revk/ESP32-PN532/PCB/Round/README.md

# Round

These files are for use in [KiCad](https://www.kicad.org).

## Trademark

This is an open source project, but bear in mind you cannot sell boards bearing the Andrews & Arnold Ltd name, the A&A logo, the registered trademark AJK logo, or the GS1 allocated EANs assigned to Andrews & Arnold Ltd.

## Images

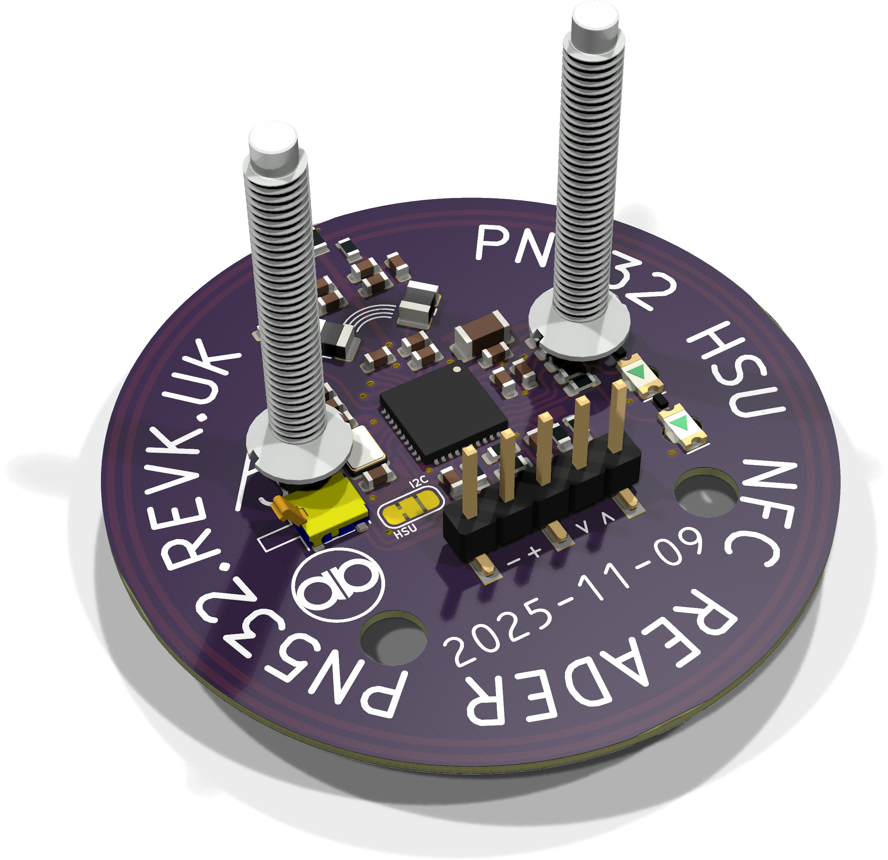
[picture p2: PCB/Round/Round.png]
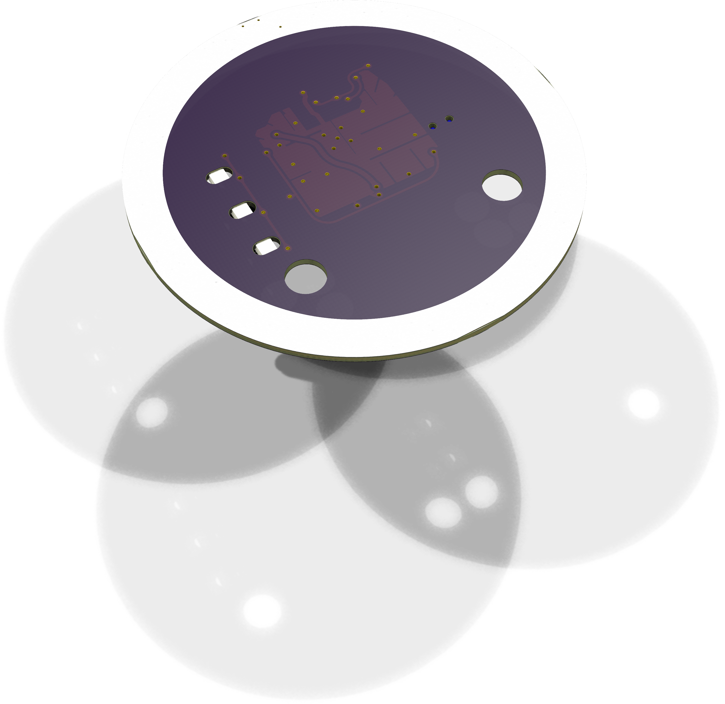
[picture p3: PCB/Round/Round-bottom.png]

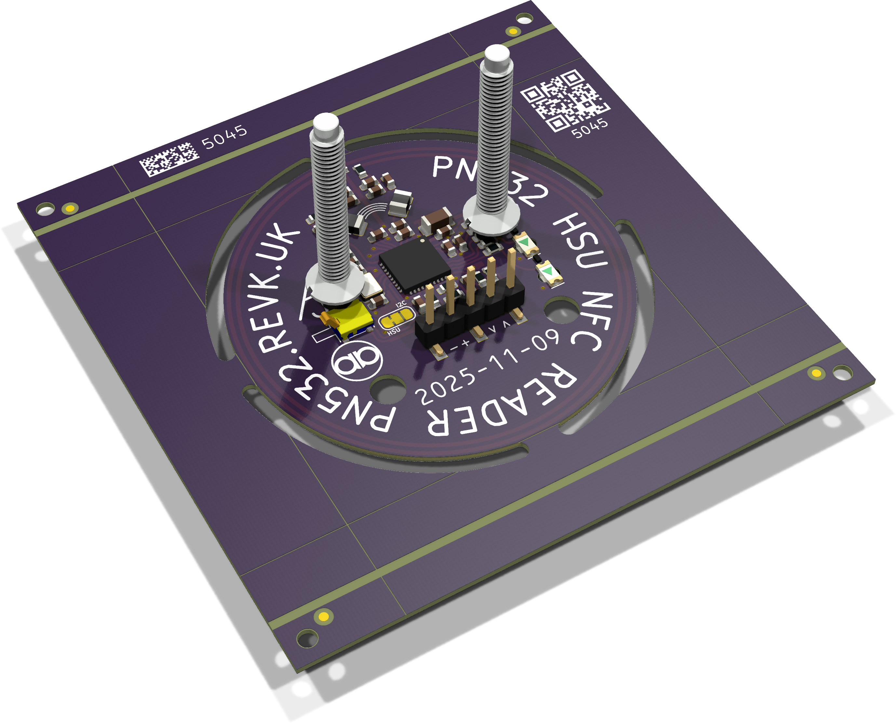
[picture p4: PCB/Round/Round-panel.png]
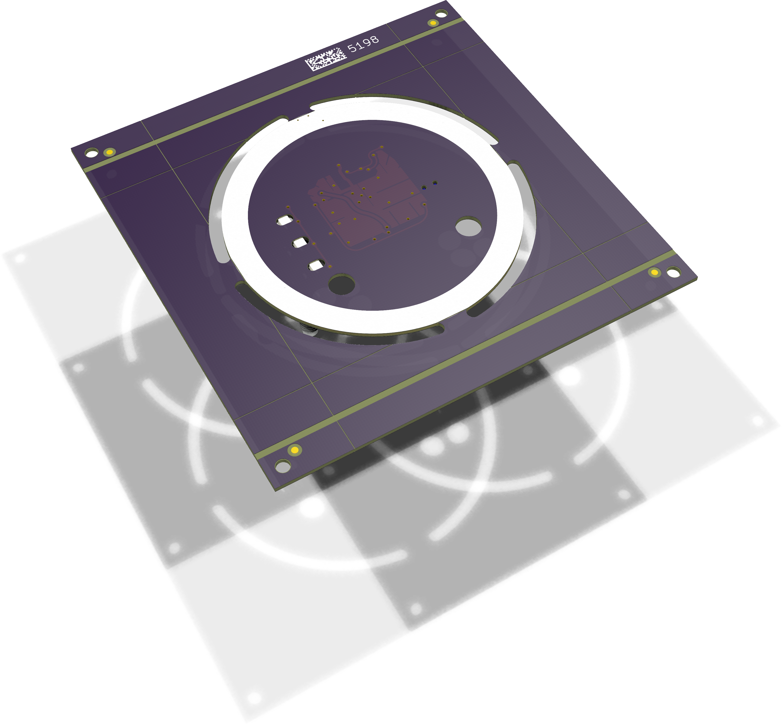
[picture p5: PCB/Round/Round-panel-bottom.png]


*Auto generated 2025-08-22T10:13:34*
