revk/ESP32-PN532/PCB/Square/README.md

# Square

These files are for use in [KiCad](https://www.kicad.org).

## Trademark

This is an open source project, but bear in mind you cannot sell boards bearing the Andrews & Arnold Ltd name, the A&A logo, the registered trademark AJK logo, or the GS1 allocated EANs assigned to Andrews & Arnold Ltd.

## Images

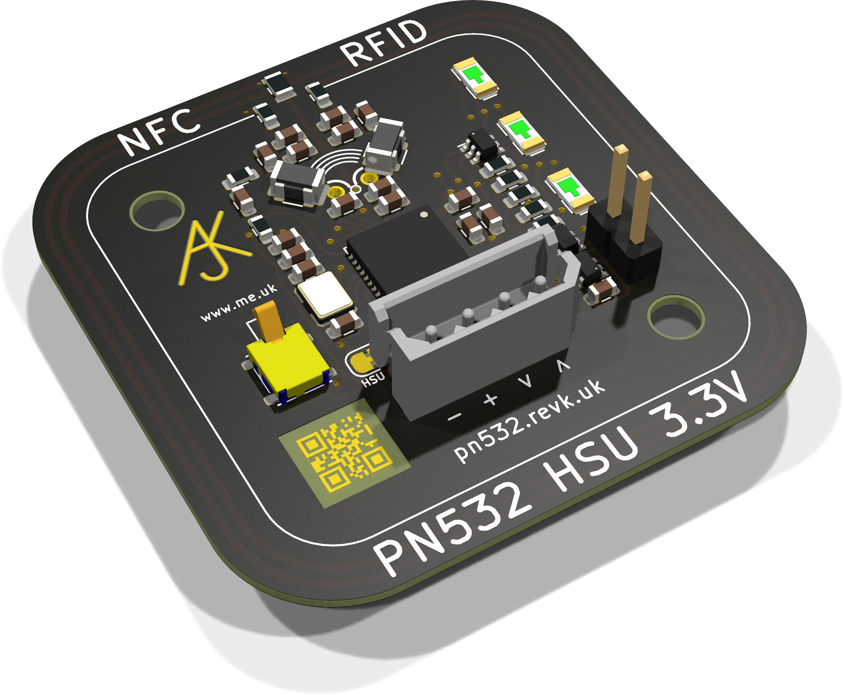
[picture p6: PCB/Square/Square.png]
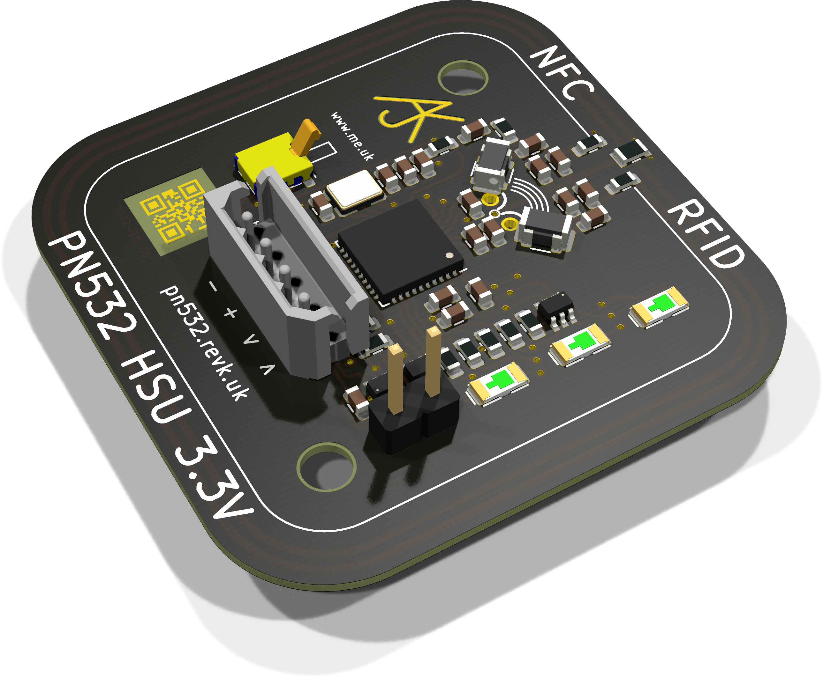
[picture p7: PCB/Square/Square-90.png]
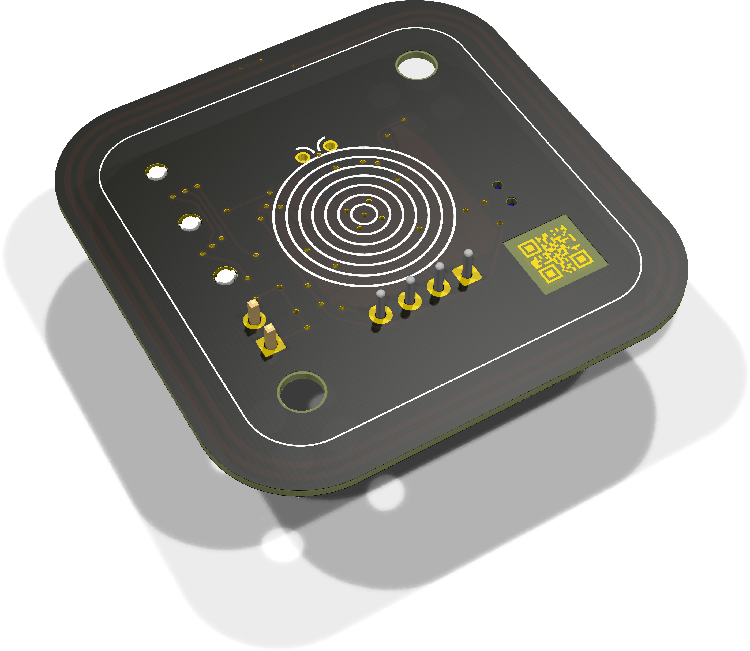
[picture p8: PCB/Square/Square-bottom.png]


*Auto generated 2025-08-17T07:40:48*
