revk/ESP32-PN532/PCB/blankplate.png

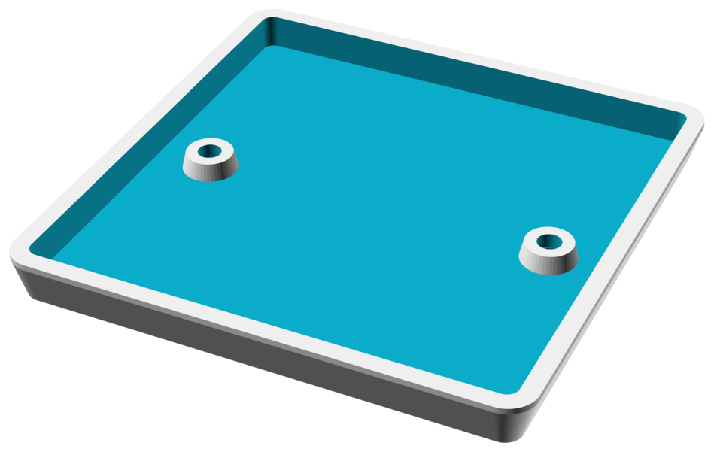
PCB/blankplate.png
