revk/ESP32-PN532/PCB/Round-Base.png

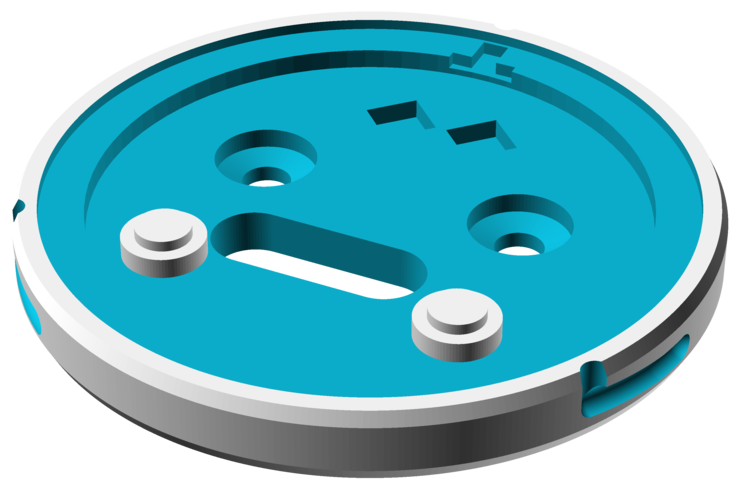
PCB/Round-Base.png
