revk/ESP32-PN532/PCB/Round-Plate90.png

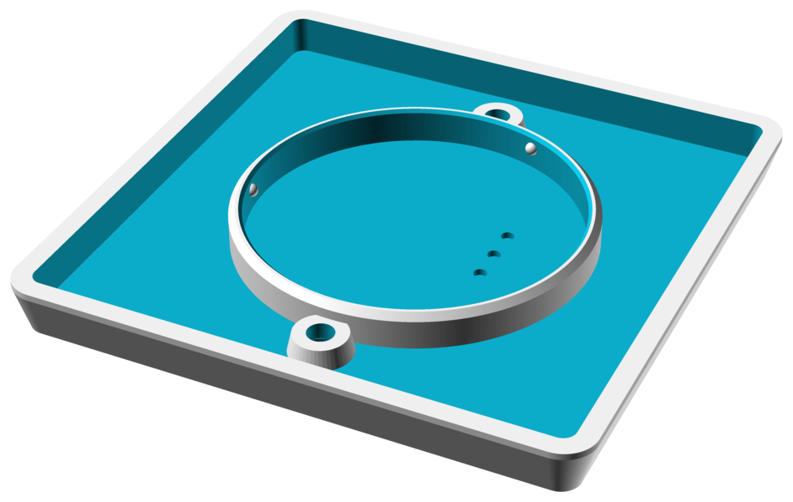
PCB/Round-Plate90.png
