revk/ESP32-PN532/PCB/Round-Top.png

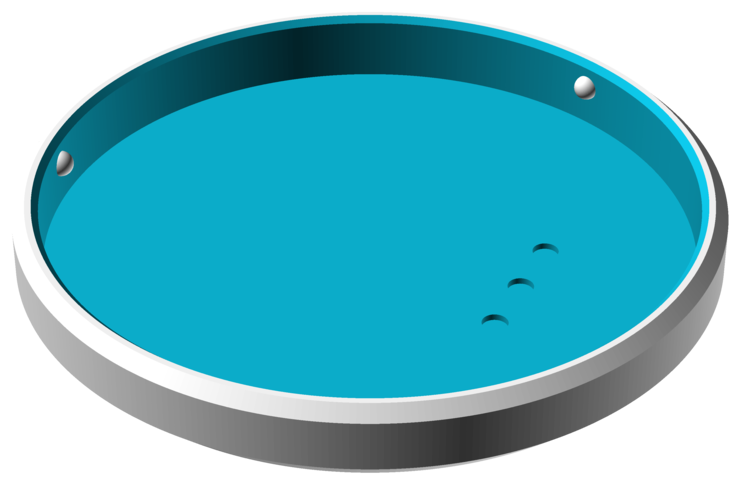
PCB/Round-Top.png
