revk/ESP32-PN532/PCB/Square/Cable.stl

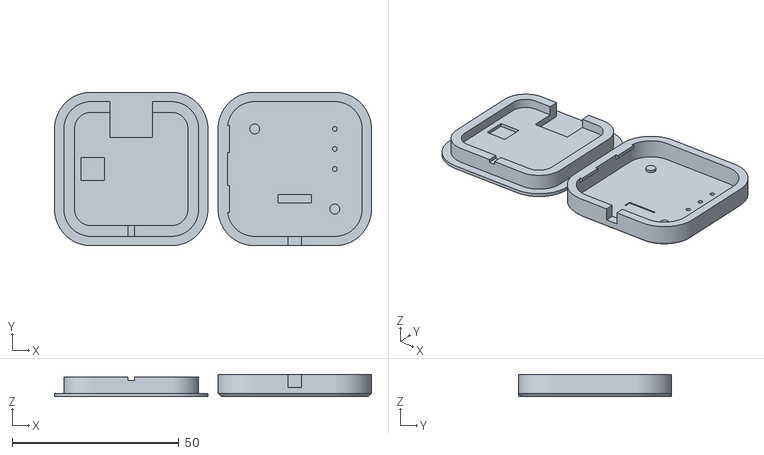
[picture p13: CAD file, 2023-07-02]
PCB/Square/Cable.stl
95.0 x 46.0 x 6.70
