revk/ESP32-PN532/PCB/Square/Wall.stl

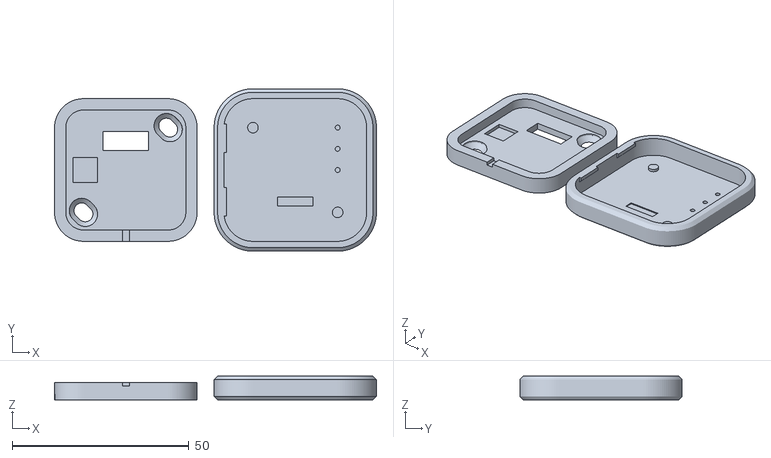
[picture p14: CAD file, 2023-07-02]
PCB/Square/Wall.stl
91.2 x 46.0 x 6.70
