revk/ESP32-PN532/PCB/Square/Thick.stl

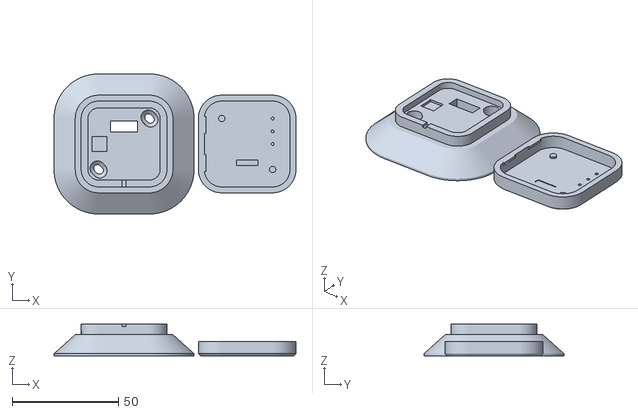
[picture p15: CAD file, 2023-07-02]
PCB/Square/Thick.stl
114.0 x 66.0 x 14.9
