revk/ESP32-PN532/PCB/Round-Plate.scad

include <Round.scad>
use <blankplate.scad>
use <Round-top.scad>

difference()
{
    blankplate();
    cylinder(r=pcbr+wall,h=base);
}
top(top=2); // to match blankplate
