revk/ESP32-PN532/PCB/Round.scad

// Design for round base to print in resin

pcbr=46/2;
pcbt=0.8;
parts=1.5;
base=5.5;
top=1.5;
wall=2;
nipple=2;
diag=0.5;
lt=2;
lb=1;
lw=2;

$fn=90;

conno=0.7; // Offset
connh=6;
connw=16;

locka=20;

ledr=1;
ledt=1;
