revk/ESP32-PN532/(list of files, cad)

Other CAD files:
PCB/Round-Plate90.scad
