revk/ESP32-PN532/(threads)

Thread 1 (2021-02-08):

Please make an example

GeorgeFlorian, 2021-02-08:
Hello.

I don't know if this is still maintained or not, but I would really love an example on how to use this library.

I am currently trying to integrate RFID1356MIFARE with ESP32-EVB but with no luck.

Thank you.

revk, 2021-02-08:
It is used in https://github.com/revk/SolarSystem which should give a good example.

GeorgeFlorian, 2021-02-09:
> It is used in https://github.com/revk/SolarSystem which should give a good example.

I trust that it is, but I find it hard to follow. Can you point me to the right files ? Thank you.

revk, 2021-03-23:
pn532_init is where you tell it the uart and pins. It is probably worth reading the include file to start with.

revk, 2021-04-23:
I think that answers the question.

Closed 2021-04-23.

Thread 2 (2021-12-05):

Assembled boards

rabarar, 2021-12-05:
Revk do you sell an assembled board? I want to do some experiments to start and cook want to green up board fan for unit one.

revk, 2021-12-05:
I am thinking of doing so - chip supply is an issue, and we have been working out if they can be sold as "parts" without CE/UKCA marking, which we think they may be. But no idea when.

rabarar, 2021-12-05:
Thanks! I’ll watch the repo for an update if/when you decide you can — thanks again!

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

Closed 2021-12-05.

Thread 3 (2021-12-29):

The project symbol library cache file 'PN532-cache.lib' was not found.

hillstub, 2021-12-29:
Hi revk,
Thanks for your awesome work!!

I'm working on making an ESP32-based board (ESP32-H2 once it's available) with NFC. Currently, I'm trying to get some inspiration from your project ;-).

Unfortunately, when I open the KiCad schematic file, I'm getting the following error: "The project symbol library cache file 'PN532-cache.lib' was not found." Am I doing something wrong or is it looking for a file that's not in the repo?

Thanks again!

revk, 2021-12-29:
OK not sure, I am just updating stuff to kicad 6 now though.

revk, 2021-12-29:
I have updated the files for KiCad 6 - hope that helps.

hillstub, 2021-12-29:
Yes! That resolved the issue - tnx!!

Closed 2021-12-29.

Thread 4 (2022-09-23):

Code sample using library fucntions

freitasartur, 2022-09-23:
Hi, would you mind providing a code sample using the library functions?

I'm begineer in nfc and I'm not sure on how to use it.

Thank you very much in advance.

Artur

revk, 2022-09-23:
See https://github.com/revk/SolarSystem/blob/master/ESP32/main/nfc.c

Closed 2022-09-23.

Thread 5 (2023-01-21):

Interesting project.

RaveGun, 2023-01-21:
Nice project.

I did some, too much, time ago for the office where I work, a NFC reader to count the number of coffees each one is drinking. We all have some NFC access IDs with unique ID number. The device is made out of the Wemos D1 Mini, a SD card adapter, an OLED display, a PN532 dev-board (the bigger blue one) and a custom board to glue everything together. It is all in my GitHub.

Now that our team has expanded was needed to build another one and it was so hard to find similar parts that are working like the old one. The software is also old and I just found the binary from back then and programmed the new board. After a lot of stress and debugging I managed to make a new device. This made me thinking I should try to build a new version with newer components.

**Do you think that the PN532 is still the way to go for a NFC reader?**
I need to mention that the IDs are of some Desfire type so I guess are more special then the regular NFC coins and need some features. The usual MFRC522 is not good enough.

I think that the ESP + NFC chip + SD card shall be integrated on one board.
The device I am thinking of does not have to be too small, it shall accommodate for an off the shelf >2.5" display.

**Can the NFC antenna be bigger than a credit card?**
For me antennas are some sort of voodoo magic.

revk, 2023-01-21:
The PN532 works with DESFire, that is what we are using it for.

I have generally kept the NFC on a separate board. I suspect it could be done on one board with care.

Antennas are voodoo, and this one works. Why do you need bigger than a credit card. It works well with the credit card size devices, from several cm away in fact.

RaveGun, 2023-01-21:
It looks like the PN532 is EOL and there are other recommended ICs now, this is why I was asking.

I was thinking that, if it is bigger I will be easier to integrate all in one PCB and save on the board to board connections.
Also, to do it on one side and then just order the PCBs with assembly. I don't know, I am just thinking(writing) out loud :)
I am an embedded SW guy and know about HW and HW design just enough to be able to find where the micro-controller's pins are going :)

Thank you for your time.

revk, 2023-01-21:
Yeh, I have not yet looked at alternative chips. Need to work out how much the interface changes as well. And designing an RF board is always, err, fun... So I may well make a new design soon. But PN532 work well for now.

revk, 2023-01-21:
Also, the PN7150 does not have HSU or GPIO. For my applications the reader is on a short lead which is far better done as HSU where the pins are driven all the time, than I2C, and I use the GPIO for LEDs. Would be interesting to find a newer chip that does HSU and GPIO like the PN532. Suggestions welcome.

RaveGun, 2023-01-22:
It looks like the PN5331B3HN is the next one in the list, that is still active and matches your requirements. It has no SPI nor I2C but it has USB2.0 as an interface. This is interesting as there are now also boards in internet that have the PN532 and an USB interface (something with GRID v2).

Closed 2023-01-21.

Thread 6 (2023-04-30):

Hello,Master..

CY202032, 2023-04-30:
This PCB does not have SPI mode. I have checked that it only has HSU and I2C modes. I hope you can add SPI mode. Then I will be very happy, Thank for you!

revk, 2023-04-30:
Correct, HSU seems fast enough as the response times mainly related to the NFC side. These is a link that can change to I2C mode though. This has not been tested.

Closed 2023-04-30.

Thread 7 (2025-04-09):

I2c mode doesn't appear to work

3rdIteration, 2025-04-09:
I'm looking at adapting this for a raspberry pi hat and got a few of the square boards fabricated as a test.

The UART functionality works, but not i2c, and when looking at the documentation and some other designs, I think the communication mode pins are backwards.

I'm happy to make a tweak, have it fabbed, test and bring a PR if that helps.

revk, 2025-04-09:
I have only ever tested UART as it seems fast enough (most time is not in the comms).

But if just wrong way around it just needs labels changed I assume.

Thread 8 (2025-05-10):

nice...

smoochiee, 2025-05-10:
any chance on how you design antenna and inputs?

revk, 2025-05-10:
It's all voodoo.

To start, I made exact same length as someone else's design.

I then did some trial and error on the tuning caps on the final board.

smoochiee, 2025-05-10:
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

does i2c works on this?..you have discord?

revk, 2025-05-10:
I have not tested I2C, but there is a link to change the lines to be I2C, so it should - check datasheet to be sure.

I found serial to be better as lines properly driven both ways (unlike I2C with pull ups), and the time for serial data transfer is not the limiting factor. So especially if on longer wires the serial approach is way better.

discord? no?

smoochiee, 2025-05-10:
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

what caps usually you change... i want to design a rfid antenna to fit my boardhttps://github.com/user-attachments/assets/f25bb927-b065-4898-b3a3-12e6f198d1a5

revk, 2025-05-10:
The 22pF ones

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

smoochiee, 2025-05-10:
> The 22pF ones
>
> 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

thanks...you use this?
https://eds.st.com/antenna/#/

smoochiee, 2025-05-10:
> The 22pF ones
>
> 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

and this r56 inductor is fix for this pn532?its in datasheet?thanks..
