revk/ESP32-PN532/PCB/Round/Round.kicad_pcb

## KiCad design PCB/Round/Round.kicad_pcb (2025-11-09)

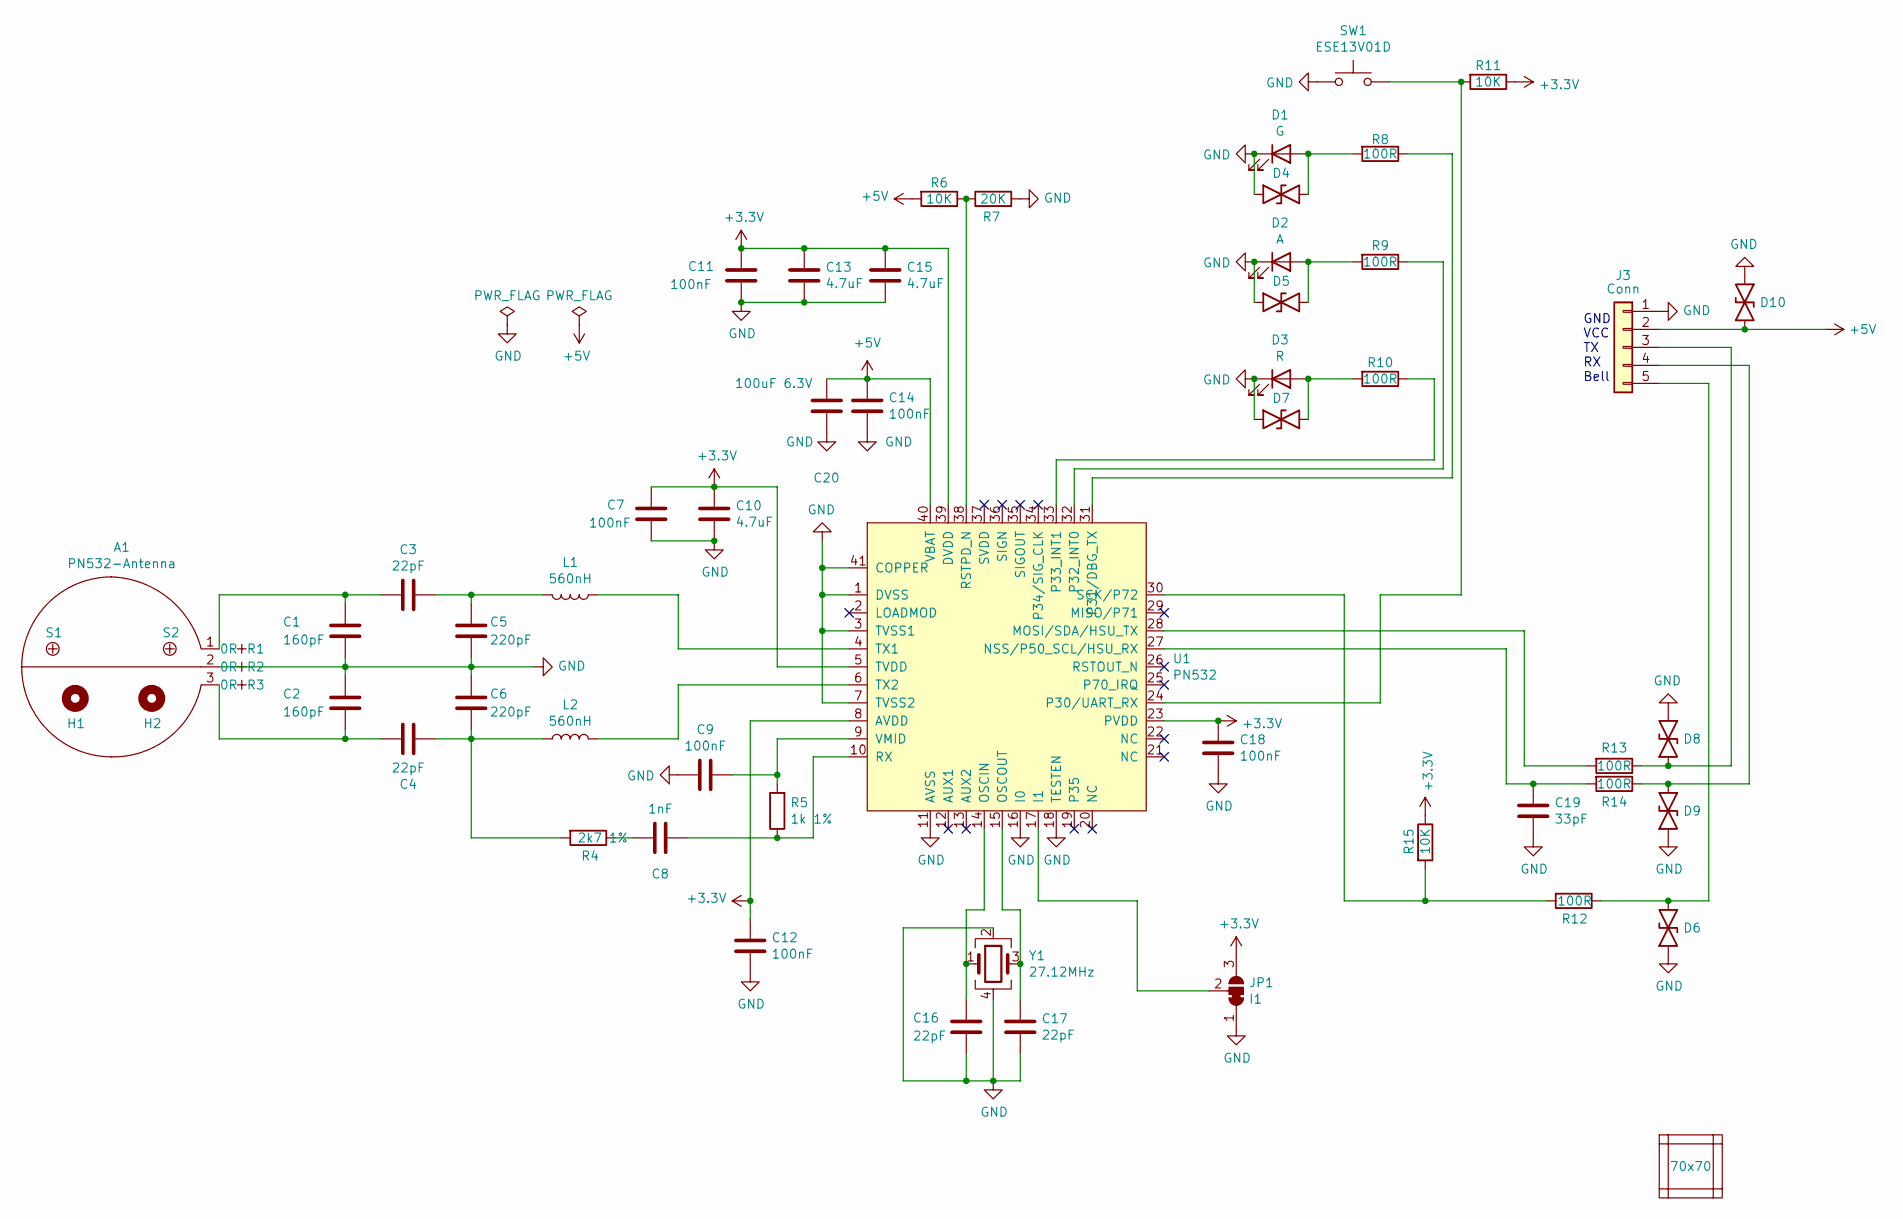
[picture p16: schematic Round.kicad_sch, PN532 NFC Board]

Parts:
A1: PN532-Antenna; PN532-Antenna6
C1, C2: 160pF; C_0603
C3, C4: 22pF; C_0603; Part No 0603N220F500CT
C5, C6: 220pF; C_0603; Part No 0603-220pF-50V
C7, C9, C11, C12, C14, C18: 100nF; C_0603; Part No 0603-100nF-25V
C8: 1nF; C_0603; Part No VJ0603A102GXAPW1BC
C10, C13, C15: 4.7uF; C_0603; Part No 0603-4.7uF-10V
C16, C17: 22pF; C_0603; Part No 0603-22pF-50V
C19: 33pF; C_0603; Part No 0603-33pF-50V
C20: 100uF 6.3V; C_1206
D1: G; LED_1206_Rev_Square; Part No 156120VS75300
D2: A; LED_1206_Rev_Square; Part No 156120YS75300
D3: R; LED_1206_Rev_Square; Part No 156120RS75300
D4, D5, D6, D7, D8, D9, D10: DFN1006-2L; MPN C5137770
H1, H2: MountingHole; MountingHole_4mm
J3: Conn; PinHeader_1x05_P2.54mm_Vertical_SMD_Pin1Left; MPN C2883802
JP1: I1; SolderJumper3
L1, L2: 560nH; L_1008_2520Metric; Part No LQW2UASR56G00L
PCB1: 70x70; PCB7070
R1, R3: 0R; R_0603_; MPN 0603
R2: 0R; R_0805_; MPN C17477
R4: 2k7 1%; R_0603; MPN C114612
R5: 1k 1%; R_0603; Part No CRCW06031K00FKEAC
R6, R11, R15: 10K; R_0603; MPN C25804
R7: 20K; R_0603; MPN C4184
R8, R9, R10, R13, R14: 100R; R_0603; MPN C22775
R12: 100R; R_0603; MPN 0603-100R
S1, S2: Screw
SW1: ESE13V01D; ESE13; Part No ESE13V01D
U1: PN532; QFN-40-1EP_6x6mm_P0.5mm_EP4.6x4.6mm; MPN C28925
V1, V2, V3, V4: VCUT70
Y1: 27.12MHz; Crystal-3.2x2.5; Part No ABM81-27.120MHZ-10-B1U-T3

Connections:
+3.3V: C7.1, C10.1, C11.1, C12.1, C13.1, C15.1, C18.1, JP1.3 (B), R11.1, R15.1, U1.5 (TVDD), U1.8 (AVDD), U1.23 (PVDD), U1.39 (DVDD)
+5V: C14.1, C20.2, D10.2, J3.2, R6.2, U1.40 (VBAT)
GND: A1.2, C1.2, C2.1, C5.1, C6.1, C7.2, C9.2, C10.2, C11.2, C12.2, C13.2, C14.2, C15.2, C16.2, C17.2, C18.2, C19.2, C20.1, D1.1 (K), D2.1 (K), D3.1 (K), D4.2, D5.2, D6.2, D7.2, D8.1, D9.2, D10.1, J3.1, JP1.1 (A), R7.2, SW1.1, U1.1 (DVSS), U1.3 (TVSS1), U1.7 (TVSS2), U1.11 (AVSS), U1.16 (I0), U1.18 (TESTEN), U1.41 (COPPER), Y1.2, Y1.4
unnamed: A1.1, C1.1, C3.2
unnamed: A1.3, C2.2, C4.1
unnamed: C3.1, C5.2, L1.2
unnamed: C4.2, C6.2, L2.1, R4.2
unnamed: C8.2, R4.1
unnamed: D1.2 (A), D4.1, R8.2
unnamed: D2.2 (A), D5.1, R9.2
unnamed: D3.2 (A), D7.1, R10.2
unnamed: D8.2, J3.3, R13.1
unnamed: D9.1, J3.4, R14.1
unnamed: D6.1, J3.5, R12.1
unnamed: JP1.2 (C), U1.17 (I1)
unnamed: R13.2, U1.28 (MOSI/SDA/HSU_TX)
unnamed: C19.1, R14.2, U1.27 (NSS/P50_SCL/HSU_RX)
unnamed: C16.1, U1.14 (OSCIN), Y1.1
unnamed: C17.1, U1.15 (OSCOUT), Y1.3
unnamed: R11.2, SW1.2, U1.24 (P30/UART_RX)
unnamed: R8.1, U1.31 (P31/DBG_TX)
unnamed: R9.1, U1.32 (P32_INT0)
unnamed: R10.1, U1.33 (P33_INT1)
unnamed: R6.1, R7.1, U1.38 (RSTPD_N)
unnamed: C8.1, R5.1, U1.10 (RX)
unnamed: R12.2, R15.2, U1.30 (SCK/P72)
unnamed: L1.1, U1.4 (TX1)
unnamed: L2.2, U1.6 (TX2)
unnamed: C9.1, R5.2, U1.9 (VMID)

Notes on the sheet:
GND VCC TX RX Bell

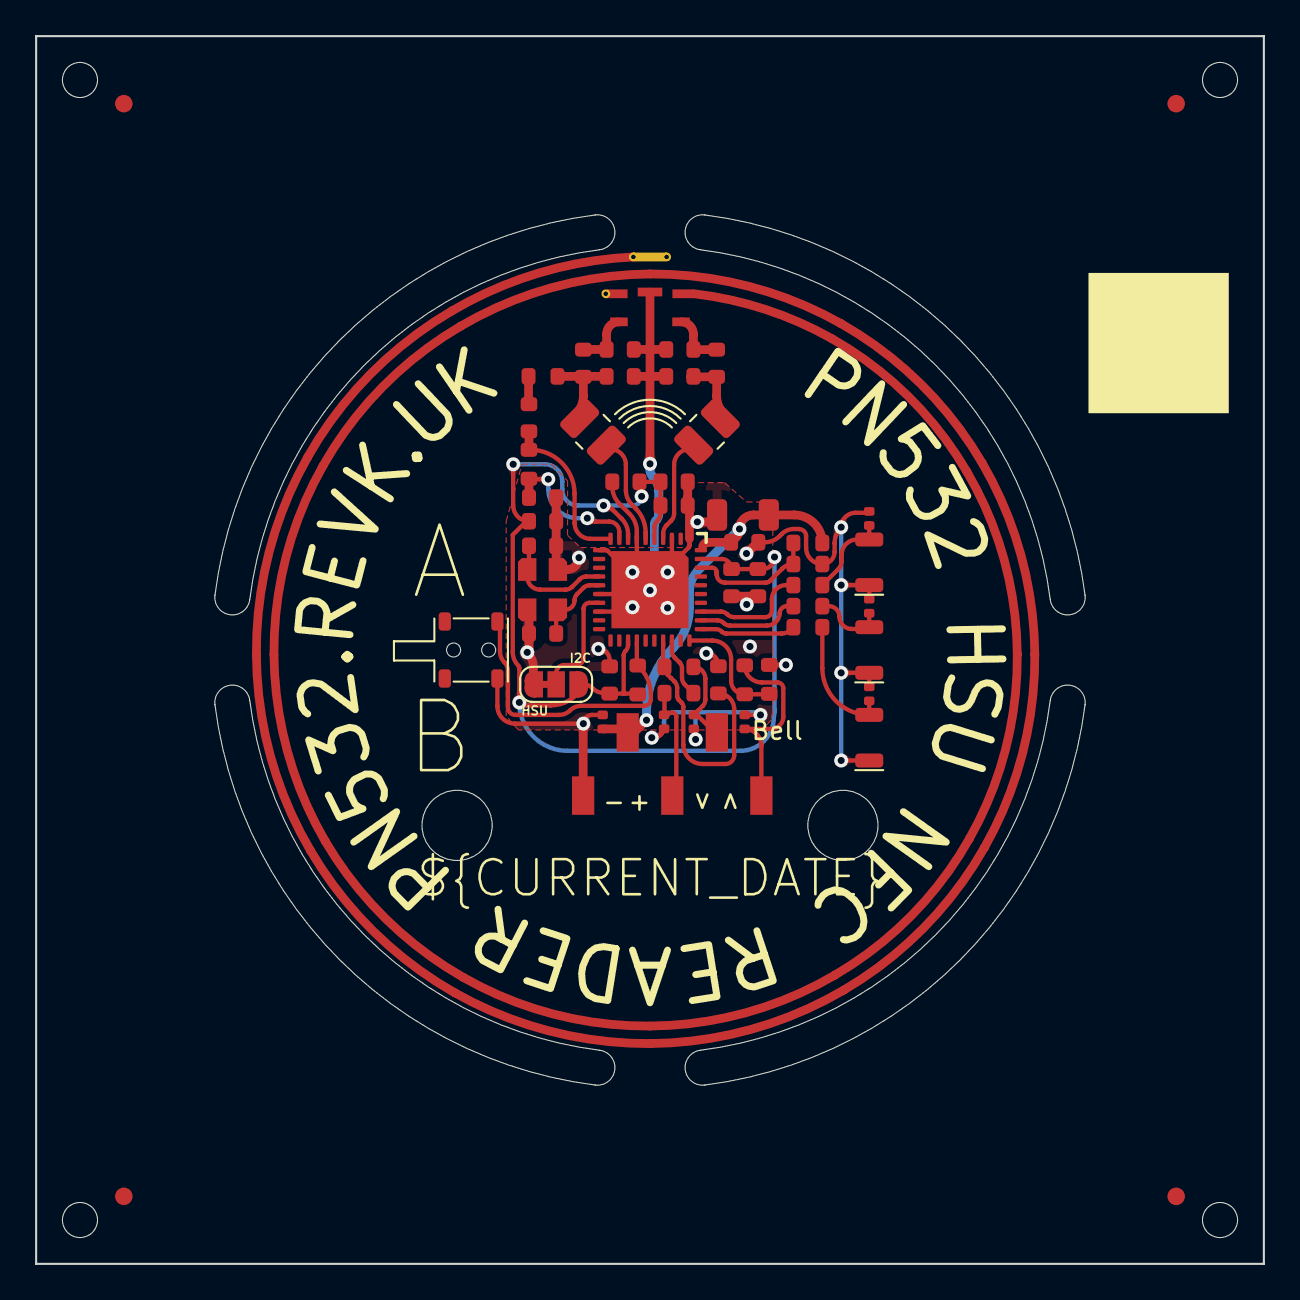
[picture p17: board Round.kicad_pcb from above]

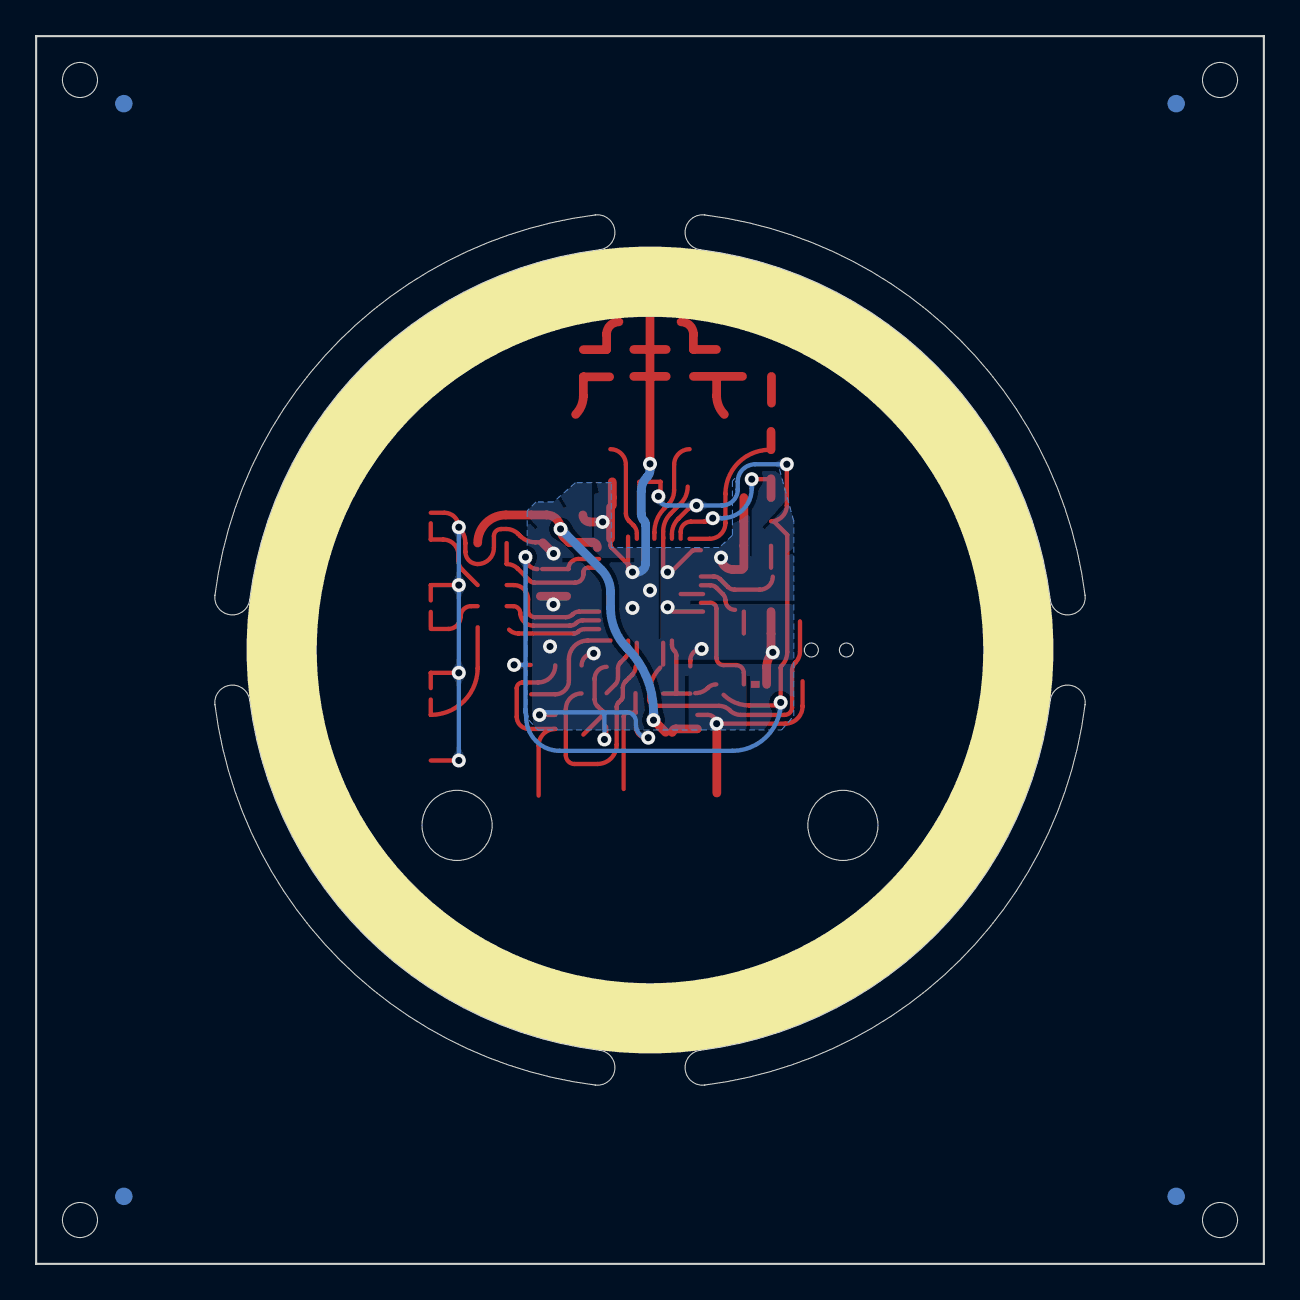
[picture p18: board Round.kicad_pcb from below]

Board: 2 copper layers, 70.0 x 70.0 mm, 62 parts (4 on the bottom side), 29 nets.
