revk/ESP32-PN532/makeloop.c

/* General spiral track - for PN532 antenna */
/* (c) 2021 Adrian Kennard Andrews & Arnold Ltd */

#define _GNU_SOURCE
#include <stdio.h>
#include <string.h>
#include <time.h>
#include <popt.h>
#include <err.h>
#include <float.h>
#include <fcntl.h>
#include <sys/stat.h>
#include <sys/mman.h>
#include <stdlib.h>
#include <ctype.h>
#include <unistd.h>
#include <math.h>

int
main (int argc, const char *argv[])
{
   const char *name = "PN532-Antenna6";
   const char *text = NULL;
   double startr = 22.69;
   double width = 0.5;
   double step = 1.0;
   double starta = NAN;
   double enda = NAN;
   double stepa = 30;
   double edge = NAN;
   double ring = NAN;
   double texth = 3;
   double textr = 18.5;
   double textt = 0.4;
   double screwx = NAN;
   double screwy = 0;
   double screwz = 1.25;
   double zone = 8;             // Fill exclude zone starts away from antenna
   double zap = 5;              // Fill exclusion zone has slots this deep
   double spoke = 12;           // Exclude spoke angle
   double slot = 1;             // Exclude slot angle
   int outside = 0;
   int debug = 0;
   poptContext optCon;          /* context for parsing  command - line options */
   {
      const struct poptOption optionsTable[] = {
         {"name", 0, POPT_ARG_STRING | POPT_ARGFLAG_SHOW_DEFAULT, &name, 0, "Name"},
         {"text", 0, POPT_ARG_STRING | POPT_ARGFLAG_SHOW_DEFAULT, &text, 0, "Text"},
         {"texth", 0, POPT_ARG_STRING | POPT_ARGFLAG_SHOW_DEFAULT, &texth, 0, "Text height"},
         {"startr", 0, POPT_ARG_DOUBLE | POPT_ARGFLAG_SHOW_DEFAULT, &startr, 0, "Start (outer) radius"},
         {"textr", 0, POPT_ARG_STRING | POPT_ARGFLAG_SHOW_DEFAULT, &textr, 0, "Text radius"},
         {"textt", 0, POPT_ARG_STRING | POPT_ARGFLAG_SHOW_DEFAULT, &textt, 0, "Text thickness"},
         {"width", 0, POPT_ARG_DOUBLE | POPT_ARGFLAG_SHOW_DEFAULT, &width, 0, "Track width"},
         {"step", 0, POPT_ARG_DOUBLE | POPT_ARGFLAG_SHOW_DEFAULT, &step, 0, "Step per turn"},
         {"starta", 0, POPT_ARG_DOUBLE | POPT_ARGFLAG_SHOW_DEFAULT, &starta, 0, "Start angle"},
         {"enda", 0, POPT_ARG_DOUBLE | POPT_ARGFLAG_SHOW_DEFAULT, &enda, 0, "End angle"},
         {"stepa", 0, POPT_ARG_DOUBLE | POPT_ARGFLAG_SHOW_DEFAULT, &stepa, 0, "Step angle"},
         {"screwx", 0, POPT_ARG_DOUBLE, &screwx, 0, "Screw X"},
         {"screwy", 0, POPT_ARG_DOUBLE, &screwy, 0, "Screw Y"},
         {"screwz", 0, POPT_ARG_DOUBLE | POPT_ARGFLAG_SHOW_DEFAULT, &screwz, 0, "Screw Z"},
         {"edge", 0, POPT_ARG_DOUBLE | POPT_ARGFLAG_SHOW_DEFAULT, &edge, 0, "Edge"},
         {"ring", 0, POPT_ARG_DOUBLE | POPT_ARGFLAG_SHOW_DEFAULT, &ring, 0, "Ring"},
         {"zone", 0, POPT_ARG_DOUBLE | POPT_ARGFLAG_SHOW_DEFAULT, &zone, 0, "Keepout clearance"},
         {"zap", 0, POPT_ARG_DOUBLE | POPT_ARGFLAG_SHOW_DEFAULT, &zap, 0, "Keepout slot length"},
         {"spoke", 0, POPT_ARG_DOUBLE | POPT_ARGFLAG_SHOW_DEFAULT, &spoke, 0, "Keepout slot spacing"},
         {"slot", 0, POPT_ARG_DOUBLE | POPT_ARGFLAG_SHOW_DEFAULT, &slot, 0, "Keepout slot width"},
         {"outside", 0, POPT_ARG_NONE, &outside, 0, "Outside contact"},
         {"debug", 'v', POPT_ARG_NONE, &debug, 0, "Debug"},
         POPT_AUTOHELP {}
      };

      optCon = poptGetContext (NULL, argc, argv, optionsTable, 0);
      /* poptSetOtherOptionHelp(optCon, ""); */

      int c;
      if ((c = poptGetNextOpt (optCon)) < -1)
         errx (1, "%s: %s\n", poptBadOption (optCon, POPT_BADOPTION_NOALIAS), poptStrerror (c));

   }
   if (!outside && isnan (screwx))
      screwx = startr * 12 / 23;
   if (isnan (starta))
      starta = outside ? 7 : 2.4;
   if (isnan (enda))
      enda = outside ? 722.7 : 713;
   if (!outside && !text)
      text = "PN532 HSU NFC READER PN532.REVK.UK";
   if (!outside && isnan (ring))
      ring = 16;

#define	LF	"%.2lf"
#define	RES	100
   double basex = 0,
      basey = 0;

   inline double xr (double a, double r)
   {
      return round ((r * sin (a * M_PI / 180.0) - basex) * RES) / RES;
   }
   inline double x (double a)
   {
      double r = startr - step * a / 360;
      if (a < 0)
         r = startr;
      return xr (a, r);
   }
   inline double yr (double a, double r)
   {
      return round ((-r * cos (a * M_PI / 180.0) + step / 4 - basey) * RES) / RES;
   }
   inline double y (double a)
   {
      double r = startr - step * a / 360;
      if (a < 0)
         r = startr;
      return yr (a, r);
   }

   printf ("(footprint \"%s\" (layer \"F.Cu\") (version 20211014) ", name);
   printf ("(attr through_hole exclude_from_pos_files exclude_from_bom)");
   printf ("(fp_text reference \"Ref**\" (at 0 0) (layer \"F.SilkS\") hide (effects (font (size 1.27 1.27) (thickness 0.15))))");
   printf ("(fp_text value \"Val**\" (at 0 0) (layer \"F.SilkS\") hide (effects (font (size 1.27 1.27) (thickness 0.15))))");
   if (!isnan (edge) && edge)
      printf ("(fp_circle (center 0 0) (end " LF " 0) (layer \"Edge.Cuts\") (width 0.1) (fill none))", edge);
   if (!isnan (ring) && ring)
      printf ("(fp_circle (center 0 0) (end " LF " 0) (layer \"Dwgs.User\") (width 0.2) (fill none))", ring);
   if (text && *text)
   {
      const char thin[] = ".:'";
      double s = texth / (textr - texth / 2) * 0.9,
         a = 0;
      for (const char *p = text; *p; p++)
         a += (strchr (thin, *p) ? s / 2 : s);
      a = M_PI - a / 2 + s / 2;
      for (const char *p = text; *p; p++)
      {
         if (strchr (thin, *p))
            a -= s / 4;
         if (*p != ' ')
            printf ("(fp_text user \"%c\" (at " LF " " LF " " LF " unlocked) (layer \"F.SilkS\")(effects (font (size " LF " " LF
                    ") (thickness " LF "))))", *p, textr * sin (a), -textr * cos (a), -180 * a / M_PI, texth, texth, textt);
         if (strchr (thin, *p))
            a -= s / 4;
         a += s;
      }
   }
   {                            /* Components */
      /* top link */
      int d = outside ? -1 : 1;
      double dy = y (roundl (enda / 360) * 360) - y (roundl (starta / 360) * 360);
      if (dy > 1.5 && dy < 2.5)
      {                         /* 0805 2mm high */
         double a = outside ? enda : starta;
         double Y = y (a);
         double W = x (a) * 2;
         // Holes
         printf ("(pad \"0\" thru_hole circle (at " LF " " LF ") (size " LF " " LF ") (drill " LF ") (layers *.Cu))", W / 2, Y,
                 width, width, width / 2);
         printf ("(pad \"0\" thru_hole circle (at " LF " " LF ") (size " LF " " LF ") (drill " LF ") (layers *.Cu))", -W / 2, Y,
                 width, width, width / 2);
         // Join holes
         printf ("(pad \"0\" smd rect (at 0 " LF " 0) (size " LF " " LF ") (layers \"F.Cu\" \"B.Cu\"))", Y, W, width);
         // Centre tap pad
         printf ("(pad \"0\" smd rect (at 0 " LF " 0) (size 1.4 " LF ") (layers \"F.Paste\" \"F.Mask\"))", Y, width);
         // Centre dot
         Y += d;
         printf ("(fp_circle (center 0 " LF ") (end 0.05 " LF ") (layer \"Dwgs.User\") (width 0.12) (fill none))", Y, Y);
         // Contact pad
         Y += d;
         printf ("(pad \"2\" smd rect (at 0 " LF " 0) (size 1.4 " LF ") (layers \"F.Cu\" \"F.Paste\" \"F.Mask\"))", Y, width);
      }
      /* 0603 1.6 mm high */
      double a = outside ? starta : enda;
      // Hole
      printf ("(pad \"0\" thru_hole circle (at " LF " " LF ") (size " LF " " LF ") (drill " LF ") (layers *.Cu))", x (a), y (a),
              width, width, width / 2);
      for (int m = -1; m <= 1; m += 2)
      {
         double X = x (a) + width / 4;
         double Y = y (a);
         if (outside)
            X -= 1 + width;
         // Copper
         printf ("(pad \"0\" smd rect (at " LF " " LF " 0) (size " LF " " LF ") (layers \"F.Cu\"))",
                 m * (X + 0.5 + (outside ? width / 2 : 0)), Y, 1 + width / 2, width);
         // Mask
         X += width / 4;
         printf ("(pad \"0\" smd rect (at " LF " " LF " 0) (size 1 " LF ") (layers \"F.Paste\" \"F.Mask\"))", m * (X + 0.5), Y,
                 width);
         // Dot
         Y += d * 0.8;
         printf ("(fp_circle (center " LF " " LF ") (end " LF " " LF ") (layer \"Dwgs.User\") (width 0.12) (fill none))",
                 m * (X + 0.5), Y, m * (X + 0.5 + 0.05), Y);
         Y += d * 0.8;
         printf ("(pad \"%d\" smd rect (at " LF " " LF " 0) (size 1 " LF ") (layers \"F.Cu\" \"F.Paste\" \"F.Mask\"))", m + 2,
                 m * (X + 0.5), Y, width);
      }
      if (!isnan (screwx))
      {
         printf ("(model \"/Users/adrian/Documents/KiCad/3D/653612.stp\" (offset (xyz " LF " " LF " " LF
                 ")) (scale (xyz 0.58 0.58 0.58)) (rotate (xyz 0 -90 -35)))", screwx, screwy, screwz);
         printf ("(model \"/Users/adrian/Documents/KiCad/3D/653612.stp\" (offset (xyz " LF " " LF " " LF
                 ")) (scale (xyz 0.58 0.58 0.58)) (rotate (xyz 0 -90 -35)))", -screwx, -screwy, screwz);
      }
   }
   void pad (const char *layer, double flip)
   {
      basex = basey = 0;
      printf ("(pad \"0\" smd custom (at " LF " " LF ") (size " LF " " LF
              ") (layers \"%s\") (options (clearance outline) (anchor circle)) (primitives ", flip * x (starta), y (starta), width,
              width, layer);
      basex = x (starta);
      basey = y (starta);
      void arc (double s, double e)
      {
         double m = (s + e) / 2;
         printf ("(gr_arc (start " LF " " LF ") (mid " LF " " LF ") (end " LF " " LF ") (width " LF "))", flip * x (s), y (s),
                 flip * x (m), y (m), flip * x (e), y (e), width);
      }
      double a = 0;
      if (starta < 0)
         arc (starta, 0);
      else if (starta > 0 && starta < stepa)
         arc (starta, a = stepa);
      for (; a + stepa < enda; a += stepa)
         arc (a, a + stepa);
      if (a < enda)
         arc (a, enda);
      printf ("))");
      basex = basey = 0;
   }
   /* the antenna itself */
   pad ("F.Cu", -1);
   pad ("B.Cu", 1);
   if (zone)
   {
      printf
         ("(zone(net 0)(net_name \"0\")(layers \"F&B.Cu\")(hatch edge 0.5)(connect_pads(clearance 0))(min_thickness 0.25)(filled_areas_thickness no)(keepout(tracks allowed)(vias allowed)(pads allowed)(copperpour not_allowed)(footprints allowed))(fill(thermal_gap 0.5)(thermal_bridge_width 0.5))(polygon(pts");
      double delta = spoke / 2;
      void zy (double a, double r)
      {
         printf ("(xy " LF " " LF ")", xr (a + delta, r), yr (a + delta, r));
      }
      zy (0, startr + step * 2 + zone);
      for (double a = -slot / 2; a < 360; a += spoke)
      {
         zy (a, startr + step * 2 + zone);
         zy (a, startr + step * 2 + zone + zap);
         zy (a + slot, startr + step * 2 + zone + zap);
         zy (a + slot, startr + step * 2 + zone);
      }
      zy (0, startr + step * 2 + zone);
      zy (0, startr - zone);
      for (double a = -slot / 2; a < 360; a += spoke)
      {
         zy (-a, startr - zone);
         zy (-a, startr - zone - zap);
         zy (-a - slot, startr - zone - zap);
         zy (-a - slot, startr - zone);
      }
      zy (0, startr - zone);
      printf (")))");
   }
   printf (")");
   poptFreeContext (optCon);
   return 0;
}
