revk/ESP32-PN532/include/pn532.h

// PN532 functions
// Copyright © 2019-2025 Adrian Kennard, Andrews & Arnold Ltd. See LICENCE file for details. GPL 3.0

#ifndef	PN532_H
#define PN532_H

#include <stdio.h>
#include <stdint.h>
#include <stddef.h>
#include <string.h>
#include <unistd.h>
#include <stdlib.h>

#ifndef	ESP_PLATFORM
extern int pn532_debug;
extern int pn532_dump;
#endif

#define pn532_errs		\
	p(OK)			\
	p(NULL)			\
	p(BAD)			\
	p(NOTPENDING)		\
	p(CMDPENDING)		\
	p(CMDMISMATCH)		\
	p(TIMEOUT)		\
	p(TIMEOUTACK)		\
	p(BADACK)		\
	p(ERROR)		\
	p(NACK)			\
	p(HEADER)		\
	p(SHORT)		\
	p(SPACE)		\
	p(CHECKSUM)		\
	p(POSTAMBLE)		\
	p(STATUS)		\
	s(0x01,TIMEOUT)		\
	s(0x02,CRC)		\
	s(0x03,PARITY)		\
	s(0x04,BITCOUNT)	\
	s(0x05,FRAMING)		\
	s(0x06,COLLISION)	\
	s(0x07,SPACE)		\
	s(0x09,OVERFLOW)	\
	s(0x0A,NOFIELD)		\
	s(0x0B,PROTOCOL)	\
	s(0x0D,TEMPERATURE)	\
	s(0x0E,INTOVERFLOW)	\
	s(0x10,PARAMETER)	\
	s(0x12,DEPPROTOCOL)	\
	s(0x13,DEPFORMAT)	\
	s(0x14,MIFAREAUTH)	\
	s(0x23,UIDCHECK)	\
	s(0x25,DEPSTATE)	\
	s(0x26,NOTALLOWED)	\
	s(0x27,NOTACCEPTABLE)	\
	s(0x29,RELEASED)	\
	s(0x2A,CARDSWAPPED)	\
	s(0x2B,DISAPPEARED)	\
	s(0x2C,MISMATCHID)	\
	s(0x2D,OVERCURRENT)	\
	s(0x2E,NADMISSING)	\
	s(0x2F,MAX)		\

typedef enum
{
#define p(n)	PN532_ERR_##n,
#define s(v,n)	PN532_ERR_STATUS_##n=PN532_ERR_STATUS+v,
   pn532_errs
#undef p
#undef s
} pn532_err_t;

typedef struct pn532_s pn532_t;

// Functions
#ifdef	ESP_PLATFORM
pn532_t *pn532_init (int8_t uart, uint8_t baud, int8_t tx, int8_t rx, uint8_t p3);      // Init PN532 (P3 is port 3 output bits in use), baud is speed code 0-8 for 9600-1288000
#else
pn532_t *pn532_init (int sock, uint8_t p3);     // Init PN532 (P3 is port 3 output bits in use), baud is speed code 0-8 for 9600-1288000
#endif
void *pn532_end (pn532_t * p);  // Close and free

pn532_err_t pn532_lasterr (pn532_t *);
const char *pn532_err_to_name (int);

// Low level access functions
int pn532_tx (pn532_t *, uint8_t cmd, int, const uint8_t *, int, const uint8_t *);  // Send data to PN532 (up to two blocks) return 0 or negative for error. Starts byte after cmd
int pn532_ready (pn532_t * p);  // For async command handling: >0 if response ready, 0 if not, -ve if error (e.g. no response expected)
int pn532_rx (pn532_t *, int, uint8_t *, int, uint8_t *, int ms);       // Recv data from PN532, (in to up to two blocks) return total length or -ve for error, checks res=cmd+1 and returns from byte after

int pn532_write_GPIO (pn532_t * p, uint8_t value);      // (P72/P71 in top bits, P35-30 in rest)
int pn532_read_GPIO (pn532_t * p);      // P72/P71 in top bits, P35-30 in rest)

// Card access function - sends to card starting CMD byte, and receives reply in to same buffer, starting status byte, returns len
int pn532_dx (void *, unsigned int len, uint8_t * data, unsigned int max, const char **errstr);

// Higher level initiator functions
const char *pn532_type (pn532_t * p);   // Known types https://nfc-tools.github.io/resources/standards/iso14443A/ https://www.nxp.com/docs/en/application-note/AN10833.pdf
uint16_t pn532_atqa (pn532_t * p);      // SENS_RES/ATQA
uint8_t pn532_sak (pn532_t * p);        // SEL_RES
uint8_t *pn532_nfcid (pn532_t *, char text[21]);        // Get NFCID (first byte is len of following)
uint8_t *pn532_ats (pn532_t *); // Get ATS (first byte is len of following - note, not as received were it is len inc the length byte)
int pn532_deselect (pn532_t * p, uint8_t n);    // Send deselect ID 1 or 2
int pn532_release (pn532_t * p, uint8_t n);     // Send release ID 1 or 2
int pn532_ILPT_Send (pn532_t * p);      // Async InListPassiveTarget - used pn532_ready to check when to do pn532_Cards
int pn532_Cards (pn532_t * p);  // How many cards present (does pn532_ILPT_Send if needed)
int pn532_Present (pn532_t * p);        // Check if present still

// Higher level target functions
int pn532_target (pn532_t *p, uint16_t atqa, uint8_t sak, uint8_t *nfcid, uint8_t *gen,uint8_t*his,uint8_t*data,int max,int secs);
int pn532_get_data(pn532_t*p,uint8_t *data, unsigned int max,int secs);
int pn532_set_data(pn532_t*p,unsigned int len,const uint8_t *data);
int pn532_get_init(pn532_t*p,uint8_t *data, unsigned int max,int secs);
int pn532_set_init(pn532_t*p,unsigned int len,const uint8_t *data);

#endif
