revk/ESP32-PN532/(commit log)

2021-04-21 PCB design
    [PN532-B_Cu.gbr, PN532-B_Mask.gbr, PN532-B_Paste.gbr, PN532-B_SilkS.gbr, PN532-Edge_Cuts.gbr, PN532-F_Cu.gbr, PN532-F_Mask.gbr, PN532-F_Paste.gbr]
2021-04-21 Update README.md
    PCB added
2021-04-21 More tinkering
    [PN532-B_Cu.gbr, PN532-B_Mask.gbr, PN532-B_Paste.gbr, PN532-B_SilkS.gbr, PN532-Edge_Cuts.gbr, PN532-F_Cu.gbr, PN532-F_Mask.gbr, PN532-F_Paste.gbr]
2021-04-21 As ordered 2021-04-21
    [PN532-B_Cu.gbr, PN532-B_Mask.gbr, PN532-B_Paste.gbr, PN532-B_SilkS.gbr, PN532-Edge_Cuts.gbr, PN532-F_Cu.gbr, PN532-F_Mask.gbr, PN532-F_Paste.gbr]
2021-04-22 Swapped LEDs and tweaked track for Rx side
    [PN532-B_Cu.gbr, PN532-B_Mask.gbr, PN532-B_Paste.gbr, PN532-B_SilkS.gbr, PN532-Edge_Cuts.gbr, PN532-F_Cu.gbr, PN532-F_Mask.gbr, PN532-F_Paste.gbr]
2021-04-23 Correct PCB edge
    [PN532.kicad_pcb]
2021-04-24 Moved Tamper to top, make easier for mounting screws in 3D case base.
    [PN532-B_Cu.gbr, PN532-B_Mask.gbr, PN532-B_Paste.gbr, PN532-B_SilkS.gbr, PN532-Edge_Cuts.gbr, PN532-F_Cu.gbr, PN532-F_Mask.gbr, PN532-F_Paste.gbr]
2021-04-24 Added external tamper/button header
    [PN532-B_Cu.gbr, PN532-B_Mask.gbr, PN532-B_Paste.gbr, PN532-B_SilkS.gbr, PN532-Edge_Cuts.gbr, PN532-F_Cu.gbr, PN532-F_Mask.gbr, PN532-F_Paste.gbr]
2021-04-24 Started case
    [Case.scad]
2021-04-25 Minor tweaks :-)
    [PN532-B_Cu.gbr, PN532-B_Mask.gbr, PN532-B_Paste.gbr, PN532-B_SilkS.gbr, PN532-Edge_Cuts.gbr, PN532-F_Cu.gbr, PN532-F_Mask.gbr, PN532-F_Paste.gbr]
2021-04-25 Correct tamper height, and spox placement
    [PN532.kicad_pcb, PN532.scad]
2021-04-25 Added links to mouser for connectors
    [PN532.sch]
2021-04-25 Tidy some tracks
    [PN532-B_Cu.gbr, PN532-B_Mask.gbr, PN532-B_Paste.gbr, PN532-B_SilkS.gbr, PN532-Edge_Cuts.gbr, PN532-F_Cu.gbr, PN532-F_Mask.gbr, PN532-F_Paste.gbr]
2021-04-25 Lip, and screw fix
    [PN532.scad]
2021-04-25 Messed up the lip, D'Oh
    [PN532.scad]
2021-04-25 Fix base
    [PN532.scad]
2021-04-25 Cable entry narrower and lock in the SPOX when lid in place
    [PN532.scad]
2021-04-25 OK try that again, locking in connector
    [PN532.scad]
2021-04-25 More tweaks
    [PN532.scad]
2021-04-25 Tweaked tracks, yet again.
    [PN532-B_Cu.gbr, PN532-B_Mask.gbr, PN532-B_Paste.gbr, PN532-B_SilkS.gbr, PN532-Edge_Cuts.gbr, PN532-F_Cu.gbr, PN532-F_Mask.gbr, PN532-F_Paste.gbr]
2021-04-25 Reworked milli-grid and made button separate to tamper
    [PN532-B_Cu.gbr, PN532-B_Mask.gbr, PN532-B_Paste.gbr, PN532-B_SilkS.gbr, PN532-Edge_Cuts.gbr, PN532-F_Cu.gbr, PN532-F_Mask.gbr, PN532-F_Paste.gbr]
2021-04-25 Silk screen tweak
    [PN532-B_Cu.gbr, PN532-B_Mask.gbr, PN532-B_Paste.gbr, PN532-B_SilkS.gbr, PN532-Edge_Cuts.gbr, PN532-F_Cu.gbr, PN532-F_Mask.gbr, PN532-F_Paste.gbr]
2021-04-26 Turned LEDs sideways so could be fitted at right angles easily
    [PN532-B_Cu.gbr, PN532-B_Mask.gbr, PN532-B_Paste.gbr, PN532-B_SilkS.gbr, PN532-Edge_Cuts.gbr, PN532-F_Cu.gbr, PN532-F_Mask.gbr, PN532-F_Paste.gbr]
2021-04-27 Cleaner holes
    [PN532-B_Cu.gbr, PN532-B_Mask.gbr, PN532-B_Paste.gbr, PN532-B_SilkS.gbr, PN532-Edge_Cuts.gbr, PN532-F_Cu.gbr, PN532-F_Mask.gbr, PN532-F_Paste.gbr]
2021-04-27 Tidy tracks
    [PN532-B_Cu.gbr, PN532-B_Mask.gbr, PN532-B_Paste.gbr, PN532-B_SilkS.gbr, PN532-Edge_Cuts.gbr, PN532-F_Cu.gbr, PN532-F_Mask.gbr, PN532-F_Paste.gbr]
2021-04-27 Correct value
    [PN532-B_Cu.gbr, PN532-B_Mask.gbr, PN532-B_Paste.gbr, PN532-B_SilkS.gbr, PN532-Edge_Cuts.gbr, PN532-F_Cu.gbr, PN532-F_Mask.gbr, PN532-F_Paste.gbr]
2021-04-28 Reworked using 0603
    [PN532-B_Cu.gbr, PN532-B_Mask.gbr, PN532-B_Paste.gbr, PN532-B_SilkS.gbr, PN532-Edge_Cuts.gbr, PN532-F_Cu.gbr, PN532-F_Mask.gbr, PN532-F_Paste.gbr]
2021-04-28 Shorter loop
    [PN532-B_Cu.gbr, PN532-B_Mask.gbr, PN532-B_Paste.gbr, PN532-B_SilkS.gbr, PN532-Edge_Cuts.gbr, PN532-F_Cu.gbr, PN532-F_Mask.gbr, PN532-F_Paste.gbr]
2021-04-28 As ordered
    [PN532.kicad_pcb]
2021-04-28 Case for new design
    [PN532.scad]
2021-04-28 Revised to add vias for antenna testing (after PCB issue today)
    [PN532-B_Cu.gbr, PN532-B_Mask.gbr, PN532-B_Paste.gbr, PN532-B_SilkS.gbr, PN532-Edge_Cuts.gbr, PN532-F_Cu.gbr, PN532-F_Mask.gbr, PN532-F_Paste.gbr]
2021-04-28 Silk screen
    [PN532-B_Cu.gbr, PN532-B_Mask.gbr, PN532-B_Paste.gbr, PN532-B_SilkS.gbr, PN532-Edge_Cuts.gbr, PN532-F_Cu.gbr, PN532-F_Mask.gbr, PN532-F_Paste.gbr]
2021-04-29 Minor tidy and adjust case
    [PN532-B_Cu.gbr, PN532-B_Mask.gbr, PN532-B_Paste.gbr, PN532-B_SilkS.gbr, PN532-Edge_Cuts.gbr, PN532-F_Cu.gbr, PN532-F_Mask.gbr, PN532-F_Paste.gbr]
2021-04-29 Current 3D model
    [PN532.scad]
2021-04-29 Reworked for 9mm corners
    [PN532-B_Cu.gbr, PN532-B_Mask.gbr, PN532-B_Paste.gbr, PN532-B_SilkS.gbr, PN532-Edge_Cuts.gbr, PN532-F_Cu.gbr, PN532-F_Mask.gbr, PN532-F_Paste.gbr]
2021-04-29 As ordered NFCV4
    [PN532-B_Cu.gbr, PN532-B_Mask.gbr, PN532-B_Paste.gbr, PN532-B_SilkS.gbr, PN532-Edge_Cuts.gbr, PN532-F_Cu.gbr, PN532-F_Mask.gbr, PN532-F_Paste.gbr]
2021-04-30 Some example STL files
    [PN532-cable.stl, PN532-thick.stl, PN532-wall.stl]
2021-04-30 Correct paste
    [PN532-B_Cu.gbr, PN532-B_Mask.gbr, PN532-B_Paste.gbr, PN532-B_SilkS.gbr, PN532-Edge_Cuts.gbr, PN532-F_Cu.gbr, PN532-F_Mask.gbr, PN532-F_Paste.gbr]
2021-04-30 Moved resistors to be definitely clear of vertical SPOX
    [PN532-B_Cu.gbr, PN532-B_Mask.gbr, PN532-B_Paste.gbr, PN532-B_SilkS.gbr, PN532-Edge_Cuts.gbr, PN532-F_Cu.gbr, PN532-F_Mask.gbr, PN532-F_Paste.gbr]
2021-04-30 Adjusting connector holes
    [PN532-cable.stl, PN532-thick.stl, PN532-wall.stl, PN532.scad]
2021-05-01 Mark test points
    [PN532-B_Cu.gbr, PN532-B_Mask.gbr, PN532-B_Paste.gbr, PN532-B_SilkS.gbr, PN532-Edge_Cuts.gbr, PN532-F_Cu.gbr, PN532-F_Mask.gbr, PN532-F_Paste.gbr]
2021-05-01 Proper test points now on schematic and PCB layout for antenna tuning.
    [PN532-B_Cu.gbr, PN532-B_Mask.gbr, PN532-B_Paste.gbr, PN532-B_SilkS.gbr, PN532-Edge_Cuts.gbr, PN532-F_Cu.gbr, PN532-F_Mask.gbr, PN532-F_Paste.gbr]
2021-05-01 Cleaner tracks
    [PN532-B_Cu.gbr, PN532-B_Mask.gbr, PN532-B_Paste.gbr, PN532-B_SilkS.gbr, PN532-Edge_Cuts.gbr, PN532-F_Cu.gbr, PN532-F_Mask.gbr, PN532-F_Paste.gbr]
2021-05-04 Added JP1 link to allow I2C
    [PN532-B_Cu.gbr, PN532-B_Mask.gbr, PN532-B_Paste.gbr, PN532-B_SilkS.gbr, PN532-Edge_Cuts.gbr, PN532-F_Cu.gbr, PN532-F_Mask.gbr, PN532-F_Paste.gbr]
2021-05-04 Moved vias from under pads as better for use with solder paste. Added date to solder paste stencil
    [PN532-B_Cu.gbr, PN532-B_Mask.gbr, PN532-B_Paste.gbr, PN532-B_SilkS.gbr, PN532-Edge_Cuts.gbr, PN532-F_Cu.gbr, PN532-F_Mask.gbr, PN532-F_Paste.gbr]
2021-05-05 Some silk screen tweaks
    [PN532-B_Cu.gbr, PN532-B_Mask.gbr, PN532-B_Paste.gbr, PN532-B_SilkS.gbr, PN532-Edge_Cuts.gbr, PN532-F_Cu.gbr, PN532-F_Mask.gbr, PN532-F_Paste.gbr]
2021-05-05 Tweak footprint
    [PN532.kicad_pcb]
2021-05-05 brighter green
    [PN532-B_Cu.gbr, PN532-B_Mask.gbr, PN532-B_Paste.gbr, PN532-B_SilkS.gbr, PN532-Edge_Cuts.gbr, PN532-F_Cu.gbr, PN532-F_Mask.gbr, PN532-F_Paste.gbr]
2021-05-06 footprint name fix
    [PN532-B_Cu.gbr, PN532-B_Mask.gbr, PN532-B_Paste.gbr, PN532-B_SilkS.gbr, PN532-Edge_Cuts.gbr, PN532-F_Cu.gbr, PN532-F_Mask.gbr, PN532-F_Paste.gbr]
2021-05-06 Allow SMD tamper switch (pads)
    [PN532-B_Cu.gbr, PN532-B_Mask.gbr, PN532-B_Paste.gbr, PN532-B_SilkS.gbr, PN532-Edge_Cuts.gbr, PN532-F_Cu.gbr, PN532-F_Mask.gbr, PN532-F_Paste.gbr]
2021-05-06 Adjusted tamper
    [PN532-cable.stl, PN532-thick.stl, PN532-wall.stl, PN532.kicad_pcb, PN532.scad]
2021-05-06 Moved around tamper, as will not start with P35 grounded, grrr.
    [PN532-B_Cu.gbr, PN532-B_Mask.gbr, PN532-B_Paste.gbr, PN532-B_SilkS.gbr, PN532-Edge_Cuts.gbr, PN532-F_Cu.gbr, PN532-F_Mask.gbr, PN532-F_Paste.gbr]
2021-05-06 Back to antenna 1
    [PN532-B_Cu.gbr, PN532-B_Mask.gbr, PN532-B_Paste.gbr, PN532-B_SilkS.gbr, PN532-Edge_Cuts.gbr, PN532-F_Cu.gbr, PN532-F_Mask.gbr, PN532-F_Paste.gbr]
2021-05-07 Tidy fab
    [PN532-B_Cu.gbr, PN532-B_Mask.gbr, PN532-B_Paste.gbr, PN532-B_SilkS.gbr, PN532-Edge_Cuts.gbr, PN532-F_Cu.gbr, PN532-F_Mask.gbr, PN532-F_Paste.gbr]
2021-05-07 Case for antenna1
    [PN532-cable.stl, PN532-thick.stl, PN532-wall.stl, PN532.scad]
2021-05-08 Tidy fab layer
    [PN532.kicad_pcb]
2021-05-08 Back to later antenna as it is better, waiting on RF work to fine tune
    [PN532-cable.stl, PN532-thick.stl, PN532-wall.stl, PN532.kicad_pcb, PN532.scad, PN532.sch]
2021-05-08 Change to 1206 pads for inductor
    [PN532-B_Cu.gbr, PN532-B_Mask.gbr, PN532-B_Paste.gbr, PN532-B_SilkS.gbr, PN532-Edge_Cuts.gbr, PN532-F_Cu.gbr, PN532-F_Mask.gbr, PN532-F_Paste.gbr]
2021-05-08 Tidy a bit with smaller ground plane
    [PN532-B_Cu.gbr, PN532-B_Mask.gbr, PN532-B_Paste.gbr, PN532-B_SilkS.gbr, PN532-Edge_Cuts.gbr, PN532-F_Cu.gbr, PN532-F_Mask.gbr, PN532-F_Paste.gbr]
2021-05-08 More space around inductor.
    [PN532-B_Cu.gbr, PN532-B_Mask.gbr, PN532-B_Paste.gbr, PN532-B_SilkS.gbr, PN532-Edge_Cuts.gbr, PN532-F_Cu.gbr, PN532-F_Mask.gbr, PN532-F_Paste.gbr]
2021-05-08 Some advice re RF leading to tweaks to ground plane.
    [PN532-B_Cu.gbr, PN532-B_Mask.gbr, PN532-B_Paste.gbr, PN532-B_SilkS.gbr, PN532-Edge_Cuts.gbr, PN532-F_Cu.gbr, PN532-F_Mask.gbr, PN532-F_Paste.gbr]
2021-05-08 Complete re-layout (needs 3D case changes still)
    [PN532-B_Cu.gbr, PN532-B_Mask.gbr, PN532-B_Paste.gbr, PN532-B_SilkS.gbr, PN532-Edge_Cuts.gbr, PN532-F_Cu.gbr, PN532-F_Mask.gbr, PN532-F_Paste.gbr]
2021-05-08 Added dimensions
    [PN532-B_Cu.gbr, PN532-B_Mask.gbr, PN532-B_Paste.gbr, PN532-B_SilkS.gbr, PN532-Edge_Cuts.gbr, PN532-F_Cu.gbr, PN532-F_Mask.gbr, PN532-F_Paste.gbr]
2021-05-09 Minor updates, moved bell, 3D case updated
    [PN532-B_Cu.gbr, PN532-B_Mask.gbr, PN532-B_Paste.gbr, PN532-B_SilkS.gbr, PN532-Edge_Cuts.gbr, PN532-F_Cu.gbr, PN532-F_Mask.gbr, PN532-F_Paste.gbr]
2021-05-09 More tidying
    [PN532-B_Cu.gbr, PN532-B_Mask.gbr, PN532-B_Paste.gbr, PN532-B_SilkS.gbr, PN532-Edge_Cuts.gbr, PN532-F_Cu.gbr, PN532-F_Mask.gbr, PN532-F_Paste.gbr]
2021-05-09 More tweaks - do they ever end?
    [PN532-B_Cu.gbr, PN532-B_Mask.gbr, PN532-B_Paste.gbr, PN532-B_SilkS.gbr, PN532-Edge_Cuts.gbr, PN532-F_Cu.gbr, PN532-F_Mask.gbr, PN532-F_Paste.gbr]
2021-05-10 Double Cap pads to improve tuning options, and large inductor pad
    [PN532-B_Cu.gbr, PN532-B_Mask.gbr, PN532-B_Paste.gbr, PN532-B_SilkS.gbr, PN532-Edge_Cuts.gbr, PN532-F_Cu.gbr, PN532-F_Mask.gbr, PN532-F_Paste.gbr]
2021-05-11 Diagonal inductors for the win...
    [PN532-B_Cu.gbr, PN532-B_Mask.gbr, PN532-B_Paste.gbr, PN532-B_SilkS.gbr, PN532-Edge_Cuts.gbr, PN532-F_Cu.gbr, PN532-F_Mask.gbr, PN532-F_Paste.gbr]
2021-05-11 Paste update
    [PN532.kicad_pcb]
2021-05-12 ESD on bell, and tidy
    [PN532-B_Cu.gbr, PN532-B_Mask.gbr, PN532-B_Paste.gbr, PN532-B_SilkS.gbr, PN532-Edge_Cuts.gbr, PN532-F_Cu.gbr, PN532-F_Mask.gbr, PN532-F_Paste.gbr]
2021-05-12 Protection diodes for ESD
    [PN532-B_Cu.gbr, PN532-B_Mask.gbr, PN532-B_Paste.gbr, PN532-B_SilkS.gbr, PN532-Edge_Cuts.gbr, PN532-F_Cu.gbr, PN532-F_Mask.gbr, PN532-F_Paste.gbr]
2021-05-12 Minor final tweaks
    [PN532-B_Cu.gbr, PN532-B_Mask.gbr, PN532-B_Paste.gbr, PN532-B_SilkS.gbr, PN532-Edge_Cuts.gbr, PN532-F_Cu.gbr, PN532-F_Mask.gbr, PN532-F_Paste.gbr]
2021-05-13 Moved by 0.1mm to line up, D'Oh
    [PN532-B_Cu.gbr, PN532-B_Mask.gbr, PN532-B_Paste.gbr, PN532-B_SilkS.gbr, PN532-Edge_Cuts.gbr, PN532-F_Cu.gbr, PN532-F_Mask.gbr, PN532-F_Paste.gbr]
2021-05-13 Tidy up diode positioning and add 33pF on rx
    [PN532-B_Cu.gbr, PN532-B_Mask.gbr, PN532-B_Paste.gbr, PN532-B_SilkS.gbr, PN532-Edge_Cuts.gbr, PN532-F_Cu.gbr, PN532-F_Mask.gbr, PN532-F_Paste.gbr]
2021-05-13 Update board
2021-05-13 Documentation update
    [PN532-B_Cu.gbr, PN532-B_Mask.gbr, PN532-B_Paste.gbr, PN532-B_SilkS.gbr, PN532-Edge_Cuts.gbr, PN532-F_Cu.gbr, PN532-F_Mask.gbr, PN532-F_Paste.gbr]
2021-05-14 Correct LEDs
    [PN532.kicad_pcb]
2021-05-14 Fix I/O set up
    [pn532.c]
2021-05-15 Larger test pads
    [PN532-B_Cu.gbr, PN532-B_Mask.gbr, PN532-B_Paste.gbr, PN532-B_SilkS.gbr, PN532-Edge_Cuts.gbr, PN532-F_Cu.gbr, PN532-F_Mask.gbr, PN532-F_Paste.gbr]
2021-05-17 Final tidy for order
    [PN532-B_Cu.gbr, PN532-B_Mask.gbr, PN532-B_Paste.gbr, PN532-B_SilkS.gbr, PN532-Edge_Cuts.gbr, PN532-F_Cu.gbr, PN532-F_Mask.gbr, PN532-F_Paste.gbr]
2021-05-18 Updated logo on copper
    [PN532-B_Cu.gbr, PN532-B_Mask.gbr, PN532-B_Paste.gbr, PN532-B_SilkS.gbr, PN532-Edge_Cuts.gbr, PN532-F_Cu.gbr, PN532-F_Mask.gbr, PN532-F_Paste.gbr]
2021-05-18 A&A logo
    [PN532-B_Cu.gbr, PN532-B_Mask.gbr, PN532-B_Paste.gbr, PN532-B_SilkS.gbr, PN532-Edge_Cuts.gbr, PN532-F_Cu.gbr, PN532-F_Mask.gbr, PN532-F_Paste.gbr]
2021-05-18 Fix 3D
    [PN532-cable.stl, PN532-thick.stl, PN532-wall.stl, PN532.scad]
2021-05-20 Holes for bell pins fixed
    [PN532-B_Cu.gbr, PN532-B_Mask.gbr, PN532-B_Paste.gbr, PN532-B_SilkS.gbr, PN532-Edge_Cuts.gbr, PN532-F_Cu.gbr, PN532-F_Mask.gbr, PN532-F_Paste.gbr]
2021-06-01 Minor tweak around LEDs
    [PN532-B_Cu.gbr, PN532-B_Mask.gbr, PN532-B_Paste.gbr, PN532-B_SilkS.gbr, PN532-Edge_Cuts.gbr, PN532-F_Cu.gbr, PN532-F_Mask.gbr, PN532-F_Paste.gbr]
2021-06-01 Slot for reverse LED mounting option
    [PN532-B_Cu.gbr, PN532-B_Mask.gbr, PN532-B_Paste.gbr, PN532-B_SilkS.gbr, PN532-Edge_Cuts.gbr, PN532-F_Cu.gbr, PN532-F_Mask.gbr, PN532-F_Paste.gbr]
2021-06-02 Fix notes
    [PN532.sch]
2021-06-03 Changed to 40mm x 40mm x 0.8mm design, seems better.
    [PN532-B_Cu.gbr, PN532-B_Mask.gbr, PN532-B_Paste.gbr, PN532-B_SilkS.gbr, PN532-Edge_Cuts.gbr, PN532-F_Cu.gbr, PN532-F_Mask.gbr, PN532-F_Paste.gbr]
2021-06-03 Update drawings for new PCB
    [PN532-B_Cu.gbr, PN532-B_Mask.gbr, PN532-B_Paste.gbr, PN532-B_SilkS.gbr, PN532-Edge_Cuts.gbr, PN532-F_Cu.gbr, PN532-F_Mask.gbr, PN532-F_Paste.gbr]
2021-06-03 Tidy drawing
    [PN532-B_Cu.gbr, PN532-B_Mask.gbr, PN532-B_Paste.gbr, PN532-B_SilkS.gbr, PN532-Edge_Cuts.gbr, PN532-F_Cu.gbr, PN532-F_Mask.gbr, PN532-F_Paste.gbr]
2021-06-03 New 3D
    [PN532-cable.stl, PN532-thick.stl, PN532-wall.stl, PN532.scad]
2021-06-03 Tamper tweak
    [PN532-cable.stl, PN532-thick.stl, PN532-wall.stl]
2021-06-07 No help - flash can proper stall things
    [pn532.c]
2021-06-10 Closer tamper
    [PN532-cable.stl, PN532-thick.stl, PN532-wall.stl, PN532.scad]
2021-06-10 Tweak tamper
    [PN532-cable.stl, PN532-thick.stl, PN532-wall.stl, PN532.scad]
2021-06-13 Not the leak, so where is it?
    [pn532.c]
2021-06-13 Tamper clearance
    [PN532-cable.stl, PN532-thick.stl, PN532-wall.stl, PN532.scad]
2021-06-17 Better pads for solder paste
    [PN532-B_Cu.gbr, PN532-B_Mask.gbr, PN532-B_Paste.gbr, PN532-B_SilkS.gbr, PN532-Edge_Cuts.gbr, PN532-F_Cu.gbr, PN532-F_Mask.gbr, PN532-F_Paste.gbr]
2021-07-09 Solder paste
    [PN532-B_Cu.gbr, PN532-B_Mask.gbr, PN532-B_Paste.gbr, PN532-B_SilkS.gbr, PN532-Edge_Cuts.gbr, PN532-F_Cu.gbr, PN532-F_Mask.gbr, PN532-F_Paste.gbr]
2021-07-09 Value change
    [PN532-B_Cu.gbr, PN532-B_Mask.gbr, PN532-B_Paste.gbr, PN532-B_SilkS.gbr, PN532-Edge_Cuts.gbr, PN532-F_Cu.gbr, PN532-F_Mask.gbr, PN532-F_Paste.gbr]
2021-07-10 Soldaer paste
    [PN532-B_Cu.gbr, PN532-B_Mask.gbr, PN532-B_Paste.gbr, PN532-B_SilkS.gbr, PN532-Edge_Cuts.gbr, PN532-F_Cu.gbr, PN532-F_Mask.gbr, PN532-F_Paste.gbr]
2021-07-24 Changed to just SMD LEDs
    [PN532-B_Cu.gbr, PN532-B_Mask.gbr, PN532-B_Paste.gbr, PN532-B_SilkS.gbr, PN532-Edge_Cuts.gbr, PN532-F_Cu.gbr, PN532-F_Mask.gbr, PN532-F_Paste.gbr]
2021-08-26 Solder stencil adjust
    [PN532-B_Cu.gbr, PN532-B_Mask.gbr, PN532-B_Paste.gbr, PN532-B_SilkS.gbr, PN532-Edge_Cuts.gbr, PN532-F_Cu.gbr, PN532-F_Mask.gbr, PN532-F_Paste.gbr]
2021-11-03 Tweaked artwork / logo / LEDs
    [PN532.kicad_pcb, PN532.sch]
2021-12-29 Kicad 6
    [PN532-B_Cu.gbr, PN532-B_Mask.gbr, PN532-B_Paste.gbr, PN532-B_SilkS.gbr, PN532-B_Silkscreen.gbr, PN532-Edge_Cuts.gbr, PN532-F_Cu.gbr, PN532-F_Mask.gbr]
2021-12-30 Gerenal KIcad 6 related tidy up
    [PN532-B_Cu.gbr, PN532-B_Mask.gbr, PN532-B_Paste.gbr, PN532-B_Silkscreen.gbr, PN532-Edge_Cuts.gbr, PN532-F_Cu.gbr, PN532-F_Mask.gbr, PN532-F_Paste.gbr]
2021-12-31 Reworked slightly to ensure 0R in BOM, and passing DRC cleanly under Kicad 6
    [PN532-B_Cu.gbr, PN532-B_Mask.gbr, PN532-B_Paste.gbr, PN532-B_Silkscreen.gbr, PN532-Edge_Cuts.gbr, PN532-F_Cu.gbr, PN532-F_Mask.gbr, PN532-F_Paste.gbr]
2021-12-31 Cleaner hidden components
    [PN532-B_Cu.gbr, PN532-B_Mask.gbr, PN532-B_Paste.gbr, PN532-B_Silkscreen.gbr, PN532-Edge_Cuts.gbr, PN532-F_Cu.gbr, PN532-F_Mask.gbr, PN532-F_Paste.gbr]
2021-12-31 More minor tweaks
    [PN532-B_Cu.gbr, PN532-B_Mask.gbr, PN532-B_Paste.gbr, PN532-B_Silkscreen.gbr, PN532-Edge_Cuts.gbr, PN532-F_Cu.gbr, PN532-F_Mask.gbr, PN532-F_Paste.gbr]
2022-01-01 Part numbers
    [PN532-B_Cu.gbr, PN532-B_Mask.gbr, PN532-B_Paste.gbr, PN532-B_Silkscreen.gbr, PN532-Edge_Cuts.gbr, PN532-F_Cu.gbr, PN532-F_Mask.gbr, PN532-F_Paste.gbr]
2022-01-01 Tidy up
    [PN532.kicad_pcb]
2022-01-01 Fabrication files
    [PN532-B_Cu.gbr, PN532-B_Mask.gbr, PN532-B_Paste.gbr, PN532-B_Silkscreen.gbr, PN532-Edge_Cuts.gbr, PN532-F_Cu.gbr, PN532-F_Mask.gbr, PN532-F_Paste.gbr]
2022-01-01 All new curvy tracks and changed layout for cleaner Rx path
    [PN532-B_Cu.gbr, PN532-B_Mask.gbr, PN532-B_Paste.gbr, PN532-B_Silkscreen.gbr, PN532-Edge_Cuts.gbr, PN532-F_Cu.gbr, PN532-F_Mask.gbr, PN532-F_Paste.gbr]
2022-01-01 BOM tidy
    [PN532-B_Cu.gbr, PN532-B_Mask.gbr, PN532-B_Paste.gbr, PN532-B_Silkscreen.gbr, PN532-Edge_Cuts.gbr, PN532-F_Cu.gbr, PN532-F_Mask.gbr, PN532-F_Paste.gbr]
2022-01-01 Pos file fixes
    [PN532.kicad_pcb]
2022-01-01 More bom/pos tidy
    [PN532-B_Cu.gbr, PN532-B_Mask.gbr, PN532-B_Paste.gbr, PN532-B_Silkscreen.gbr, PN532-Edge_Cuts.gbr, PN532-F_Cu.gbr, PN532-F_Mask.gbr, PN532-F_Paste.gbr]
2022-01-01 Fix bad footprint import
    [PN532-B_Cu.gbr, PN532-B_Mask.gbr, PN532-B_Paste.gbr, PN532-B_Silkscreen.gbr, PN532-Edge_Cuts.gbr, PN532-F_Cu.gbr, PN532-F_Mask.gbr, PN532-F_Paste.gbr]
2022-01-02 Mostly cosmetic changes and a few track tweaks
    [PN532-B_Cu.gbr, PN532-B_Mask.gbr, PN532-B_Paste.gbr, PN532-B_Silkscreen.gbr, PN532-Edge_Cuts.gbr, PN532-F_Cu.gbr, PN532-F_Mask.gbr, PN532-F_Paste.gbr]
2022-01-02 Never ending tinkering
    [PN532-B_Cu.gbr, PN532-B_Mask.gbr, PN532-B_Paste.gbr, PN532-B_Silkscreen.gbr, PN532-Edge_Cuts.gbr, PN532-F_Cu.gbr, PN532-F_Mask.gbr, PN532-F_Paste.gbr]
2022-01-02 More cut down.
    [PN532-B_Cu.gbr, PN532-B_Mask.gbr, PN532-B_Paste.gbr, PN532-B_Silkscreen.gbr, PN532-Edge_Cuts.gbr, PN532-F_Cu.gbr, PN532-F_Mask.gbr, PN532-F_Paste.gbr]
2022-01-03 Cleaner up BOM
    [PN532-B_Cu.gbr, PN532-B_Mask.gbr, PN532-B_Paste.gbr, PN532-B_Silkscreen.gbr, PN532-Edge_Cuts.gbr, PN532-F_Cu.gbr, PN532-F_Mask.gbr, PN532-F_Paste.gbr]
2022-01-03 Reverse mount LEDs
    [PN532-B_Cu.gbr, PN532-B_Mask.gbr, PN532-B_Paste.gbr, PN532-B_Silkscreen.gbr, PN532-Edge_Cuts.gbr, PN532-F_Cu.gbr, PN532-F_Mask.gbr, PN532-F_Paste.gbr]
2022-01-04 Cleanup BOM more
    [PN532-B_Cu.gbr, PN532-B_Mask.gbr, PN532-B_Paste.gbr, PN532-B_Silkscreen.gbr, PN532-Edge_Cuts.gbr, PN532-F_Cu.gbr, PN532-F_Mask.gbr, PN532-F_Paste.gbr]
2022-01-05 As ordered from PCB Train today
    [PN532-B_Cu.gbr, PN532-B_Mask.gbr, PN532-B_Paste.gbr, PN532-B_Silkscreen.gbr, PN532-Edge_Cuts.gbr, PN532-F_Cu.gbr, PN532-F_Mask.gbr, PN532-F_Paste.gbr]
2022-01-06 Changed URL
    [PN532-B_Cu.gbr, PN532-B_Mask.gbr, PN532-B_Paste.gbr, PN532-B_Silkscreen.gbr, PN532-Edge_Cuts.gbr, PN532-F_Cu.gbr, PN532-F_Mask.gbr, PN532-F_Paste.gbr]
2022-01-06 Minor change
    [PN532-B_Cu.gbr, PN532-B_Mask.gbr, PN532-B_Paste.gbr, PN532-B_Silkscreen.gbr, PN532-Edge_Cuts.gbr, PN532-F_Cu.gbr, PN532-F_Mask.gbr, PN532-F_Paste.gbr]
2022-01-17 Minor tweaks, all looking good.
    [PN532-B_Cu.gbr, PN532-B_Mask.gbr, PN532-B_Paste.gbr, PN532-B_Silkscreen.gbr, PN532-Edge_Cuts.gbr, PN532-F_Cu.gbr, PN532-F_Mask.gbr, PN532-F_Paste.gbr]
2022-02-09 Tidy plated holes
    [PN532-B_Cu.gbr, PN532-B_Mask.gbr, PN532-B_Paste.gbr, PN532-B_Silkscreen.gbr, PN532-Edge_Cuts.gbr, PN532-F_Cu.gbr, PN532-F_Mask.gbr, PN532-F_Paste.gbr]
2022-02-09 Adjust LED slightly
    [PN532-B_Cu.gbr, PN532-B_Mask.gbr, PN532-B_Paste.gbr, PN532-B_Silkscreen.gbr, PN532-Edge_Cuts.gbr, PN532-F_Cu.gbr, PN532-F_Mask.gbr, PN532-F_Paste.gbr]
2022-02-18 QR + date, and tweaks
    [PN532-B_Cu.gbr, PN532-B_Mask.gbr, PN532-B_Paste.gbr, PN532-B_Silkscreen.gbr, PN532-Edge_Cuts.gbr, PN532-F_Cu.gbr, PN532-F_Mask.gbr, PN532-F_Paste.gbr]
2022-02-18 Update artwork
    [PN532-B_Cu.gbr, PN532-B_Mask.gbr, PN532-B_Paste.gbr, PN532-B_Silkscreen.gbr, PN532-Edge_Cuts.gbr, PN532-F_Cu.gbr, PN532-F_Mask.gbr, PN532-F_Paste.gbr]
2022-06-18 Tweak case designs
    [PN532-cable.stl, PN532-thick.stl, PN532-wall.stl, PN532.scad]
2022-06-18 Handle reverse LEDs
    [PN532-cable.stl, PN532-thick.stl, PN532-wall.stl, PN532.scad]
2022-06-18 Tamper height adjust
    [PN532-cable.stl, PN532-thick.stl, PN532-wall.stl, PN532.scad]
2022-06-18 Bugger tamper to allow for placement.
    [PN532-cable.stl, PN532-thick.stl, PN532-wall.stl, PN532.scad]
2022-06-21 New round circuit (unfinshed)
    [PN532-Round-B_Cu.gbr, PN532-Round-B_Mask.gbr, PN532-Round-B_Paste.gbr, PN532-Round-B_Silkscreen.gbr, PN532-Round-Edge_Cuts.gbr, PN532-Round-F_Cu.gbr, PN532-Round-F_Mask.gbr, PN532-Round-F_Paste.gbr]
2022-06-22 New antenna design
    [PN532-Round.kicad_pcb]
2022-06-22 Better antennna
    [PN532-Round-B_Cu.gbr, PN532-Round-B_Mask.gbr, PN532-Round-B_Paste.gbr, PN532-Round-B_Silkscreen.gbr, PN532-Round-Edge_Cuts.gbr, PN532-Round-F_Cu.gbr, PN532-Round-F_Mask.gbr, PN532-Round-F_Paste.gbr]
2022-06-23 Tweak screw holes, and tidy round PCB
    [PN532-Round-B_Cu.gbr, PN532-Round-B_Mask.gbr, PN532-Round-B_Paste.gbr, PN532-Round-B_Silkscreen.gbr, PN532-Round-Edge_Cuts.gbr, PN532-Round-F_Cu.gbr, PN532-Round-F_Mask.gbr, PN532-Round-F_Paste.gbr]
2022-06-29 Tidy up and new case
    [PN532-B_Cu.gbr, PN532-B_Mask.gbr, PN532-B_Paste.gbr, PN532-B_Silkscreen.gbr, PN532-Edge_Cuts.gbr, PN532-F_Cu.gbr, PN532-F_Mask.gbr, PN532-F_Paste.gbr]
2022-06-29 Library update
    [PN532-Round.stl, PN532-cable.stl, PN532-thick.stl, PN532-wall.stl]
2022-06-29 Cleaner cuts in copper
    [PN532-Round-B_Cu.gbr, PN532-Round-B_Mask.gbr, PN532-Round-B_Paste.gbr, PN532-Round-B_Silkscreen.gbr, PN532-Round-Edge_Cuts.gbr, PN532-Round-F_Cu.gbr, PN532-Round-F_Mask.gbr, PN532-Round-F_Paste.gbr]
2022-06-30 Round case
    [PN532-Round.stl, PN532-cable.stl, PN532-thick.stl, PN532-wall.stl]
2022-06-30 Better screw holes
    [PN532-Round.stl, PN532-cable.stl, PN532-thick.stl, PN532-wall.stl]
2022-06-30 Tweak access
    [PN532-Round.stl, PN532-cable.stl, PN532-thick.stl, PN532-wall.stl]
2022-07-04 Tamper needed to be tighter
    [PN532-Round.stl, PN532-cable.stl, PN532-thick.stl, PN532-wall.stl]
2022-07-08 Slight clean up
    [PN532-Round-B_Cu.gbr, PN532-Round-B_Mask.gbr, PN532-Round-B_Paste.gbr, PN532-Round-B_Silkscreen.gbr, PN532-Round-Edge_Cuts.gbr, PN532-Round-F_Cu.gbr, PN532-Round-F_Mask.gbr, PN532-Round-F_Paste.gbr]
2022-07-08 Cleaner positioning
    [PN532-Round-B_Cu.gbr, PN532-Round-B_Mask.gbr, PN532-Round-B_Paste.gbr, PN532-Round-B_Silkscreen.gbr, PN532-Round-Edge_Cuts.gbr, PN532-Round-F_Cu.gbr, PN532-Round-F_Mask.gbr, PN532-Round-F_Paste.gbr]
2022-07-12 Tidy up LEDs, etc.
    [PN532-B_Cu.gbr, PN532-B_Mask.gbr, PN532-B_Paste.gbr, PN532-B_Silkscreen.gbr, PN532-Edge_Cuts.gbr, PN532-F_Cu.gbr, PN532-F_Mask.gbr, PN532-F_Paste.gbr]
2022-07-25 Definite pin reset - probably not needed, but makes sure
    [pn532.c]
2022-08-05 Proper tamper switch
    [PN532-B_Cu.gbr, PN532-B_Mask.gbr, PN532-B_Paste.gbr, PN532-B_Silkscreen.gbr, PN532-Edge_Cuts.gbr, PN532-F_Cu.gbr, PN532-F_Mask.gbr, PN532-F_Paste.gbr]
2022-08-05 Revised layout (tamper)
    [PN532-B_Cu.gbr, PN532-B_Mask.gbr, PN532-B_Paste.gbr, PN532-B_Silkscreen.gbr, PN532-Edge_Cuts.gbr, PN532-F_Cu.gbr, PN532-F_Mask.gbr, PN532-F_Paste.gbr]
2022-08-05 Changed to new tamper
    [PN532-Round.kicad_pcb, PN532-Round.stl]
2022-08-06 Changed back.
    [PN532-Round.kicad_pcb, PN532-Round.stl, PN532-cable.stl, PN532-thick.stl, PN532-wall.stl]
2022-08-15 zip files
    [PN532-B_Cu.gbr, PN532-B_Mask.gbr, PN532-B_Paste.gbr, PN532-B_Silkscreen.gbr, PN532-Edge_Cuts.gbr, PN532-F_Cu.gbr, PN532-F_Mask.gbr, PN532-F_Paste.gbr]
2022-08-22 Made bell part of connector, optional 4 or 5 way, and removed connector for tamper as not protected and good tamper switch now.
    [PN532-Round-B_Cu.gbr, PN532-Round-B_Mask.gbr, PN532-Round-B_Paste.gbr, PN532-Round-B_Silkscreen.gbr, PN532-Round-Edge_Cuts.gbr, PN532-Round-F_Cu.gbr, PN532-Round-F_Mask.gbr, PN532-Round-F_Paste.gbr]
2022-08-23 Revised connector
    [PN532-Round-B_Cu.gbr, PN532-Round-B_Mask.gbr, PN532-Round-B_Paste.gbr, PN532-Round-B_Silkscreen.gbr, PN532-Round-Edge_Cuts.gbr, PN532-Round-F_Cu.gbr, PN532-Round-F_Mask.gbr, PN532-Round-F_Paste.gbr]
2022-12-31 v5.0 uart init
2023-01-11 Production files - not finished
    [Cable.stl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]
2023-01-12 Production nearly ready - may have to change to square LEDs.
    [Round.kicad_pcb, Round.kicad_sch, bom.csv, positions.csv]
2023-01-13 production for LEDs as well
    [Round.kicad_pcb, Round.kicad_sch, bom.csv, positions.csv]
2023-03-22 Tweak SS
    [Round.kicad_pcb]
2023-04-24 Tweaked for latest PCB
    [Cable.stl, Round.scad, Round.stl, Thick.stl, Wall.stl]
2023-07-01 Revised case
    [Cable.stl, Round.kicad_pcb, Round.scad, Round.stl, Thick.stl, Wall.stl]
2023-07-03 Cleaner edge
    [Round.kicad_pcb, positions.csv]
2023-12-21 Tidy and new ESP diodes
    [Round.kicad_pcb, Round.kicad_sch, bom.csv, designators.csv, positions.csv]
2024-05-12 5.2.1 has some checks that broke this
    [pn532.c]
2024-12-11 Playing with antenna
2024-12-11 Started on inverted antenna
    [makeloop.c]
2024-12-11 Make external antenna
2025-01-19 Not working yet
    [Round.kicad_pcb, Round.kicad_sch]
2025-01-23 PCB Update
    [Round.kicad_pcb, Round.kicad_sch, positions.csv]
2025-08-09 Re-do case
    [Round-Base.scad, Round-Top.scad, Round.kicad_pcb, designators.csv]
2025-08-10 Slight tweak
    [Round-Base.scad, Round-Top.scad]
2025-08-17 Plate 90 degrees
    [Round-Plate90.scad]
2025-08-20 Change part
    [Round.kicad_pcb, Round.kicad_sch, bom.csv, positions.csv]
2025-08-21 Screw adjust
    [Round-Base.scad]
2025-08-22 Changed locking holes
    [Round-Base.scad, Round.kicad_pcb, Round.scad]
2025-08-22 Fix angle and plate thickness
    [Round-Plate.scad, Round-Plate90.scad, Round-Top.scad]
2025-08-22 Rounder corners to match back box
    [blankplate.scad]
2025-08-23 Same thickness
    [Round-Plate.scad, Round-Plate90.scad]
2025-08-23 Arg, fix position, again
    [Round-Top.scad]
2025-09-03 Updated case logic from PCB
    [Round-Base.scad, Round-Top.scad, Round.kicad_pcb, Round.kicad_sch, Round.scad]
2025-11-09 Not sure
    [Round.kicad_pcb, Round.kicad_sch, designators.csv, positions.csv]
2025-11-09 More renders
    [Round.scad]
